mkousal/bcthesis/text/sablona-obhaj.pdf

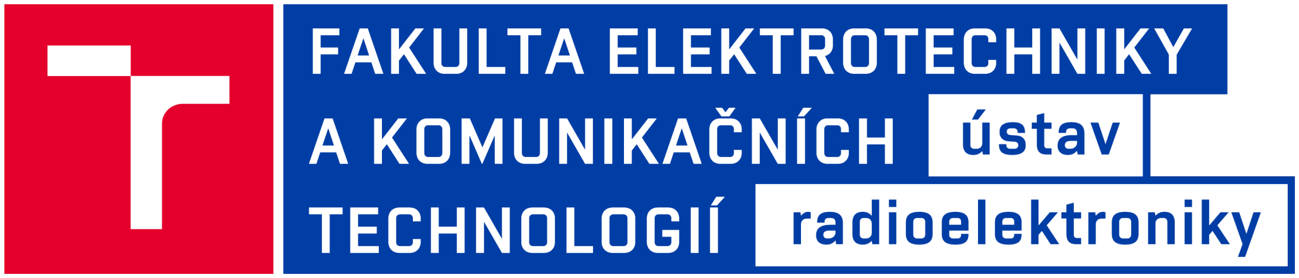
[picture p11: figure]

## IoT monitoring ovzduší

Semestrální práce

Autor práce: MARTIN KOUSAL
Vedoucí práce: doc. Ing. TOMÁŠ FRÝZA, Ph.D.
| Brno, 7. 1. 2022

## Cíle práce

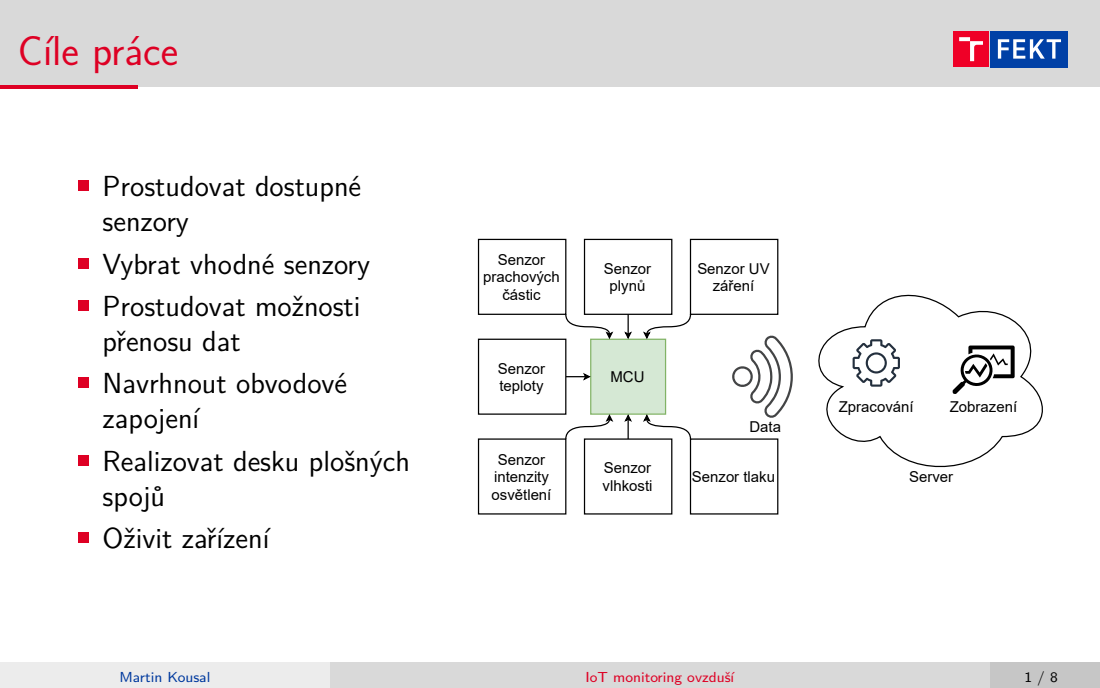
[picture p12: page 2]
MCU; Senzor prachových částic; Senzor plynů; Senzor UV záření; Senzor teploty; Senzor vlhkosti; Senzor intenzity osvětlení; Senzor tlaku; Data; Zpracování; Zobrazení; Server; Martin Kousal; IoT monitoring ovzduší

Prostudovat dostupné
senzory
Vybrat vhodné senzory
Prostudovat možnosti
přenosu dat
Navrhnout obvodové
zapojení
Realizovat desku plošných
spojů
Oživit zařízení

## Výběr senzorů - kritéria a kategorie

Kritéria
Spotřeba
Cena
Dostupnost
Komunikační sběrnice

Kategorie senzorů
Prachové částice
Oxid uhelnatý
UV záření
Intenzita osvětlení
Teplota
Tlak
Vlhkost

## Přenos a zpracování dat

Přenosové sítě
Sigfox
WiFi
LoRaWAN
NB-IoT

Server pro zpracování dat
ThingSpeak
ubidots
Arduino Cloud
Vlastní řešení
MQTT Broker
InfluxDB
Grafana

## Návrh elektroniky

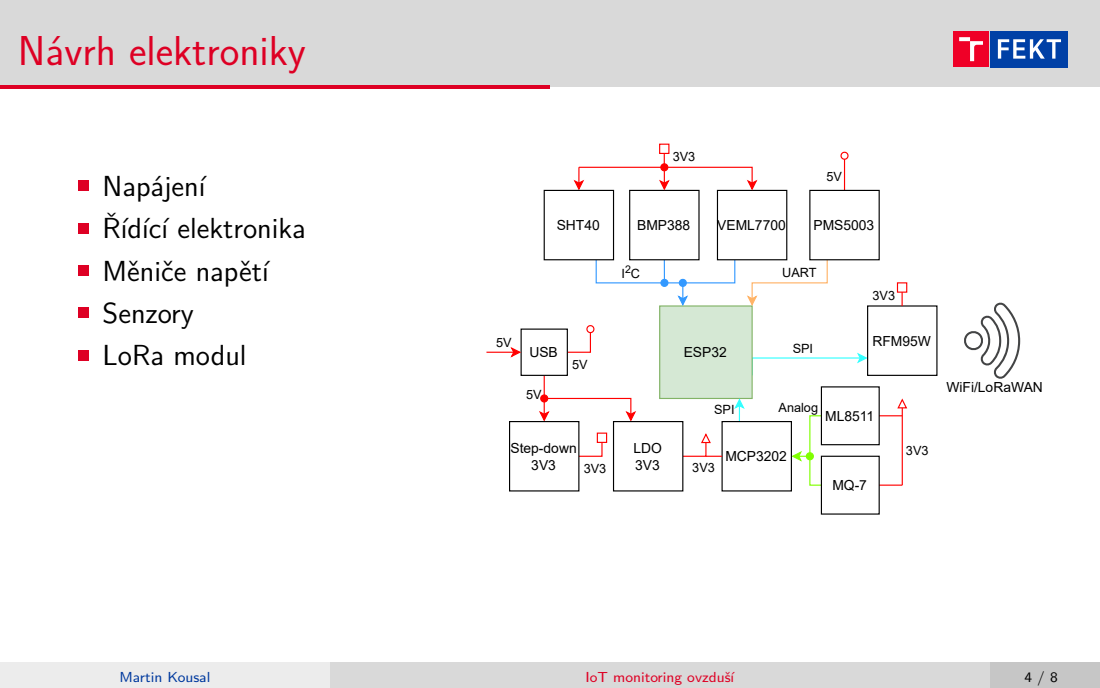
[picture p13: page 5]
Napájení Řídící elektronika; Měniče napětí; Senzory; LoRa modul; SPI ESP32; USB; WiFi/LoRaWAN; Step-down 3V3; I²C; SHT40; BMP388; VEML7700; UART; PMS5003; LDO 3V3; Analog ML8511; SPI; MCP3202; RFM95W

## Návrh DPS

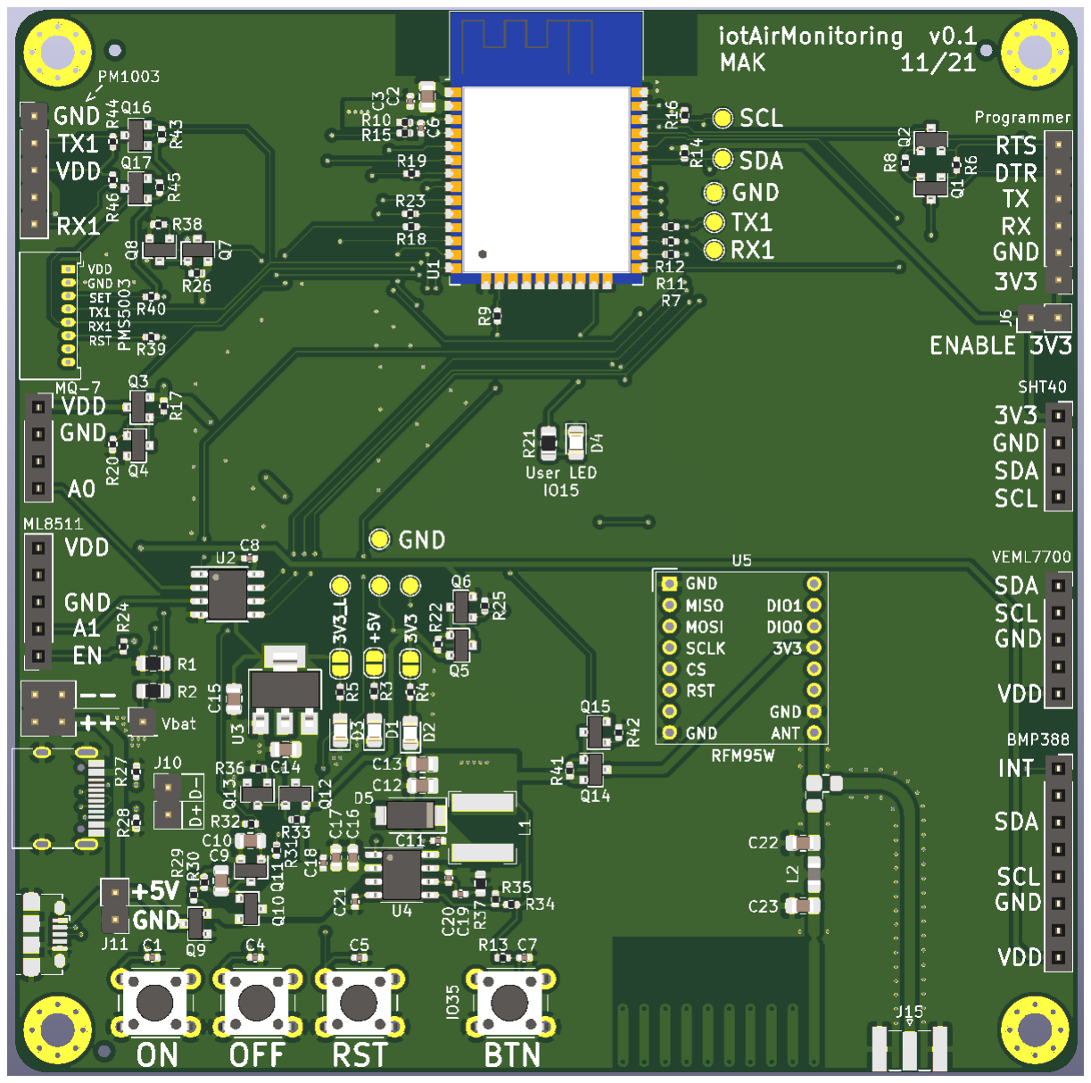
[picture p14: figure]

Dvouvrstvá DPS
Navrhováno v KiCad
Výroba JLCPCB
Strojní osazení
Velikost 100 × 100mm

## Realizovaná DPS

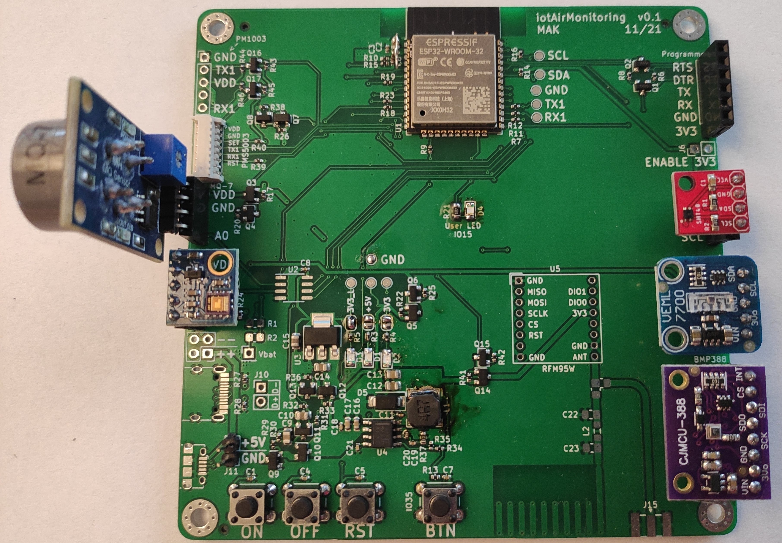
[picture p15: figure]

Osazení součástek
Možnost vypnutí
jednotlivých součástí
Spotřeba 500μA při
nečinnosti a uspaném
mikrokontroleru
Přizpůsobení antény pro
LoRa
Funkčnost všech senzorů

## Závěr

Splněné cíle
Funkční prototyp
Možnost naprogramovat mikrokontroler
Správná funkčnost dílčích logických celků
Další postup
Naprogramování firmware za použití ESP-IDF (C/C++) Vyřešení antény pro LoRa
Zprovoznění sběru dat
Další snížení klidové spotřeby Provoz na baterie

# Děkuji za pozornost!
