mkousal/bcthesis/text/nastaveni.tex

% V tomto souboru se nastavují téměř veškeré informace, proměnné mezi studenty:
% jméno, název práce, pohlaví atd.
% Tento soubor je SDÍLENÝ mezi textem práce a prezentací k obhajobě -- netřeba něco nastavovat na dvou místech.

\usepackage[
%%% Z následujících voleb jazyka lze použít pouze jednu
  czech-english,		% originální jazyk je čeština, překlad je anglicky (výchozí)
  %english-czech,	% originální jazyk je angličtina, překlad je česky
  %slovak-english,	% originální jazyk je slovenština, překlad je anglicky
  %english-slovak,	% originální jazyk je angličtina, překlad je slovensky
%
%%% Z následujících voleb typu práce lze použít pouze jednu
  %semestral,		  % semestrální práce (nesází se abstrakty, prohlášení, poděkování) (výchozí)
  bachelor,			%	bakalářská práce
  %master,			  % diplomová práce
  %treatise,			% pojednání o disertační práci
  %doctoral,			% disertační práce
%
%%% Z následujících voleb zarovnání objektů lze použít pouze jednu
%  left,				  % rovnice a popisky plovoucích objektů budou zarovnány vlevo
	center,			    % rovnice a popisky plovoucích objektů budou zarovnány na střed (vychozi)
%
]{thesis}   % Balíček pro sazbu studentských prací

%%% Jméno a příjmení autora ve tvaru
%  [tituly před jménem]{Křestní}{Příjmení}[tituly za jménem]
% Pokud osoba nemá titul před/za jménem, smažte celý řetězec '[...]'
\author{Martin}{Kousal}

%%% Identifikační číslo autora (VUT ID)
\butid{221063}

%%% Pohlaví autora/autorky
% (nepoužije se ve variantě english-czech ani english-slovak)
% Číselná hodnota: 1...žena, 0...muž
\gender{0}

%%% Jméno a příjmení vedoucího/školitele včetně titulů
%  [tituly před jménem]{Křestní}{Příjmení}[tituly za jménem]
% Pokud osoba nemá titul před/za jménem, smažte celý řetězec '[...]'
\advisor[doc. Ing.]{Tomáš}{Frýza}[Ph.D.]

%%% Jméno a příjmení oponenta včetně titulů
%  [tituly před jménem]{Křestní}{Příjmení}[tituly za jménem]
% Pokud osoba nemá titul před/za jménem, smažte celý řetězec '[...]'
% Nastavení oponenta se uplatní pouze v prezentaci k obhajobě;
% v případě, že nechcete, aby se na titulním snímku prezentace zobrazoval oponent, pouze příkaz zakomentujte;
% u obhajoby semestrální práce se oponent nezobrazuje (jelikož neexistuje)
% U dizertační práce jsou typicky dva až tři oponenti. Pokud je chcete mít na titulním slajdu, prosím ručně odkomentujte a upravte jejich jména v definici "VUT title page" v souboru thesis.sty.
\opponent[Ing.]{Aleš}{Povalač}[Ph.D.]

%%% Název práce
%  Parametr ve složených závorkách {} je název v originálním jazyce,
%  parametr v hranatých závorkách [] je překlad (podle toho jaký je originální jazyk).
%  V případě, že název Vaší práce je dlouhý a nevleze se celý do zápatí prezentace, použijte příkaz
%  \def\insertshorttitle{Zkác.\ náz.\ práce}
%  kde jako parametr vyplníte zkrácený název. Pokud nechcete zkracovat název, budete muset předefinovat,
%  jak se vytváří patička slidu. Viz odkaz: https://bit.ly/3EJTp5A
\title[IoT air monitoring]{IoT monitoring ovzduší}

%%% Označení oboru studia
%  Parametr ve složených závorkách {} je název oboru v originálním jazyce,
%  parametr v hranatých závorkách [] je překlad
\specialization[Electronics and Communication Technologies]{Elektronika a komunikační technologie}

%%% Označení ústavu
%  Parametr ve složených závorkách {} je název ústavu v originálním jazyce,
%  parametr v hranatých závorkách [] je překlad
%\department[Department of Control and Instrumentation]{Ústav automatizace a měřicí techniky}
%\department[Department of Biomedical Engineering]{Ústav biomedicínského inženýrství}
%\department[Department of Electrical Power Engineering]{Ústav elektroenergetiky}
%\department[Department of Electrical and Electronic Technology]{Ústav elektrotechnologie}
%\department[Department of Physics]{Ústav fyziky}
%\department[Department of Foreign Languages]{Ústav jazyků}
%\department[Department of Mathematics]{Ústav matematiky}
%\department[Department of Microelectronics]{Ústav mikroelektroniky}
\department[Department of Radio Electronics]{Ústav radioelektroniky}
%\department[Department of Theoretical and Experimental Electrical Engineering]{Ústav teoretické a experimentální elektrotechniky}
%\department[Department of Telecommunications]{Ústav telekomunikací}
%\department[Department of Power Electrical and Electronic Engineering]{Ústav výkonové elektrotechniky a elektroniky}

%%% Označení fakulty
%  Parametr ve složených závorkách {} je název fakulty v originálním jazyce,
%  parametr v hranatých závorkách [] je překlad
%\faculty[Faculty of Architecture]{Fakulta architektury}
\faculty[Faculty of Electrical Engineering and~Communication]{Fakulta elektrotechniky a~komunikačních technologií}
%\faculty[Faculty of Chemistry]{Fakulta chemická}
%\faculty[Faculty of Information Technology]{Fakulta informačních technologií}
%\faculty[Faculty of Business and Management]{Fakulta podnikatelská}
%\faculty[Faculty of Civil Engineering]{Fakulta stavební}
%\faculty[Faculty of Mechanical Engineering]{Fakulta strojního inženýrství}
%\faculty[Faculty of Fine Arts]{Fakulta výtvarných umění}
%
%Nastavení logotypu (v hranatych zavorkach zkracene logo, ve slozenych plne):
\facultylogo[logo/FEKT_zkratka_barevne_PANTONE_CZ]{logo/logo_fekt_urel_cze}

%%% Rok odevzdání práce
\graduateyear{2022}
%%% Akademický rok odevzdání práce
\academicyear{2021/22}

%%% Datum obhajoby (uplatní se pouze v prezentaci k obhajobě)
\date{14.\,6.\,2022}

%%% Místo obhajoby
% Na titulních stránkách bude automaticky vysázeno VELKÝMI písmeny (pokud tyto stránky sází šablona)
\city{Brno}

%%% Abstrakt
\abstract[%
The purpose of this bachelor work is to make a device that can measure air quality parameters and send them wirelessly to the server, where that measured data are processed and then shown to the user. The aim is to create a device with the lowest possible power consumption for the possibility of battery operation.
]{%
Tato bakalářská práce se zabývá vytvořením zařízení pro měření kvalitativních parametrů ovzduší a které je následně bezdrátově přenáší na server, kde se naměřená data zpracovávají a zobrazují uživateli. Cílem je vytvořit zařízení s co nejnižším odběrem pro možnost provozu na akumulátor.
}

%%% Klíčová slova
\keywrds[%
IoT, ESP32, sensors, dust particles sensor, air quality, LoRa, gas sensor, temperature, humidity, light intensity, UV light
]{%
IoT, ESP32, senzory, senzor prachových částic, kvalita vzduchu, LoRa, senzor plynů, teplota, vlhkost, intenzita osvětlení, UV záření
}

%%% Poděkování
\acknowledgement{%
Rád bych poděkoval vedoucímu bakalářské práce
panu doc.~Ing.~Tomáši Frýzovi, Ph.D.\ za odborné vedení,
konzultace, trpělivost a~podnětné návrhy k~práci.
}%
