mkousal/bcthesis/text/obrazky/flowchart.pdf

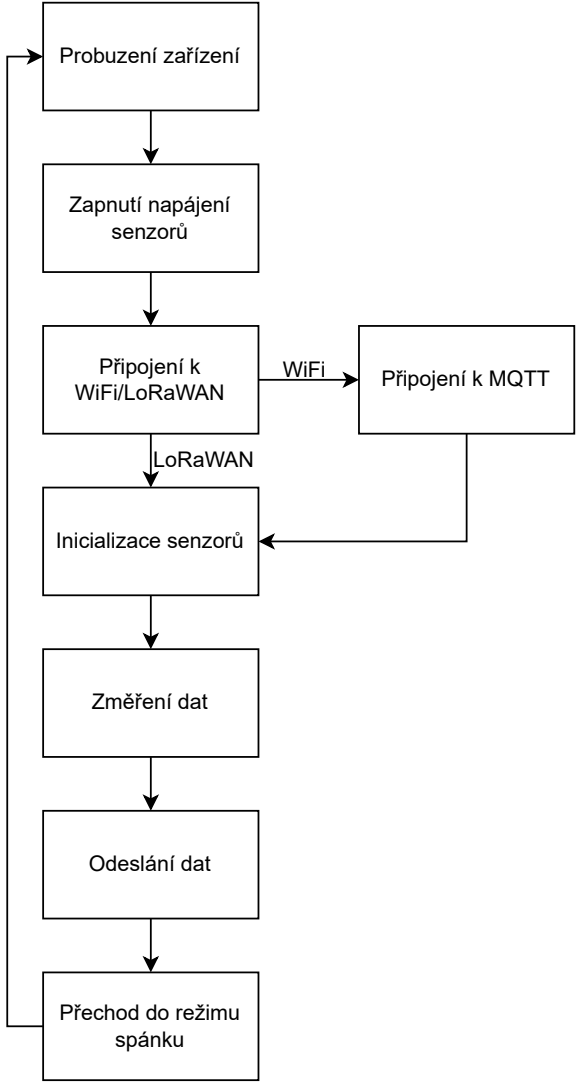
[picture p36: figure]
Probuzení zařízení; Zapnutí napájení senzorů; Připojení k WiFi/LoRaWAN; Inicializace senzorů; Změření dat; Připojení k MQTT; Odeslání dat; Přechod do režimu spánku; WiFi; LoRaWAN
