mkousal/bcthesis/text/obrazky/mq7.jpg

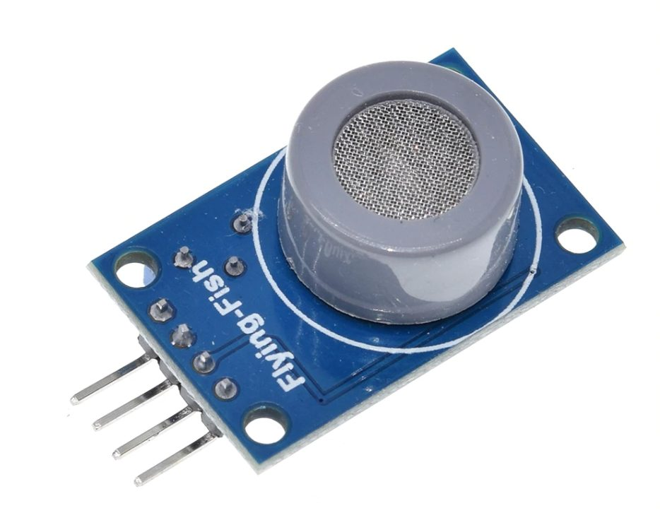
text/obrazky/mq7.jpg
