mkousal/bcthesis/text/obrazky/PCB_top.png

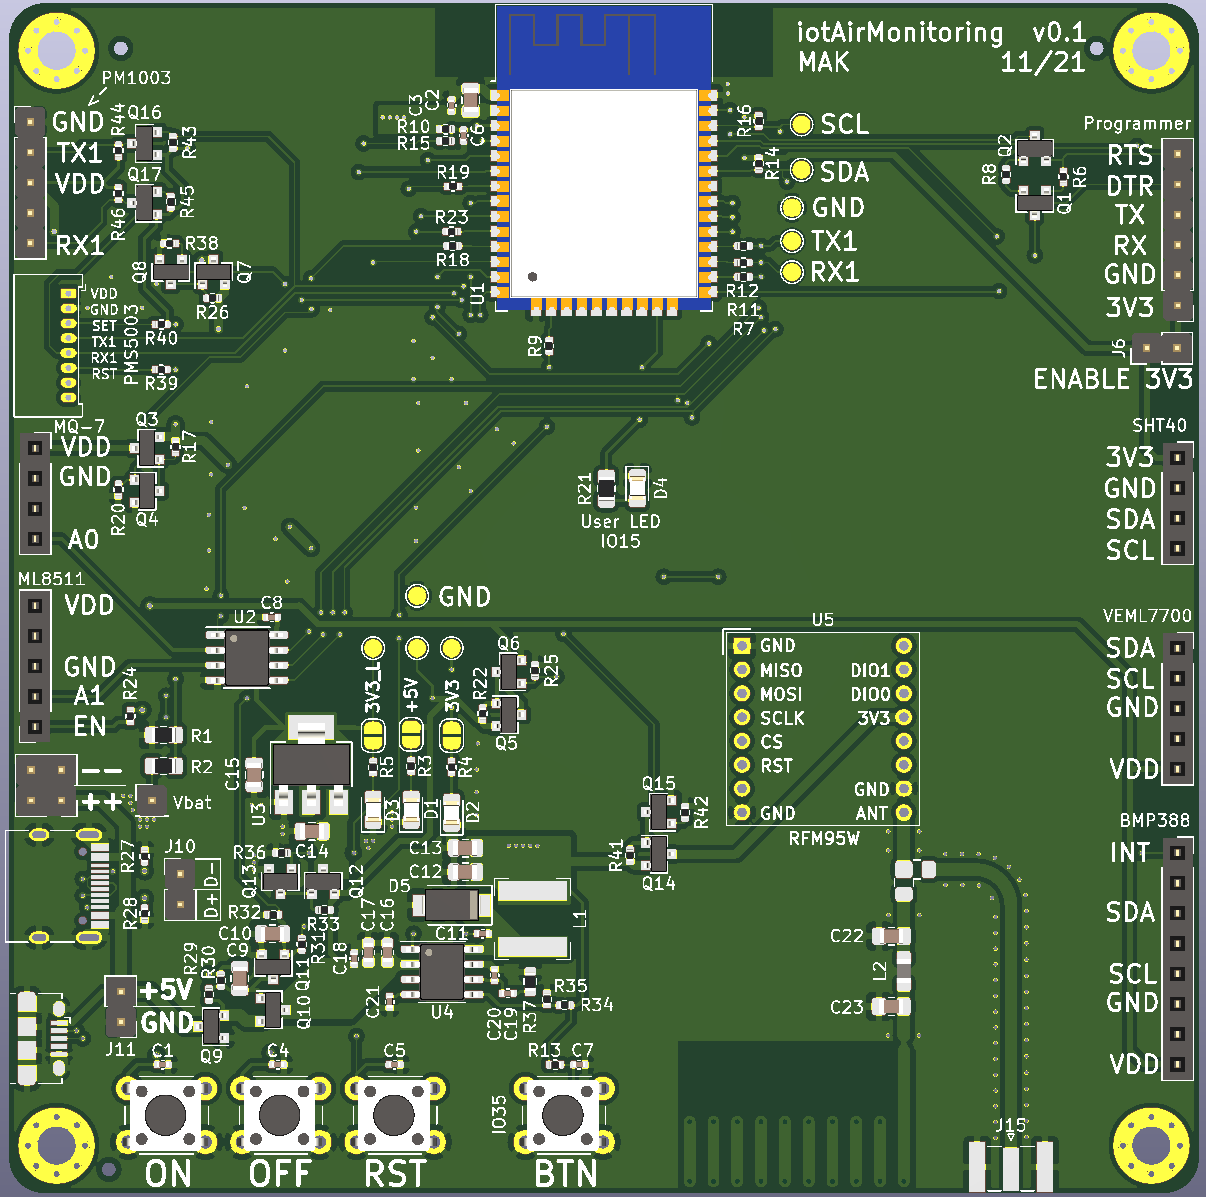
text/obrazky/PCB_top.png
