mkousal/bcthesis/text/obrazky/schematicTPS54331.png

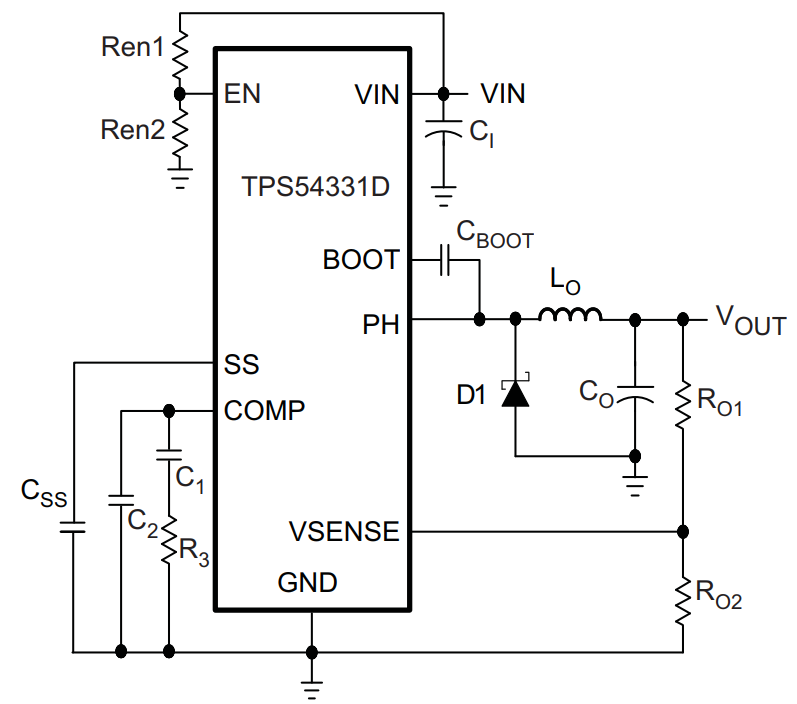
text/obrazky/schematicTPS54331.png
