mkousal/bcthesis/mec/case_bot.SLDPRT

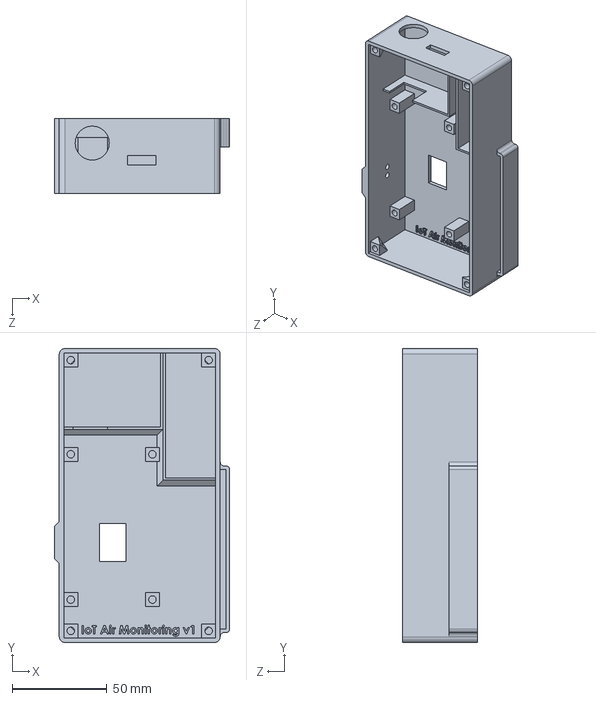
[picture p43: CAD file, 2022-05-26]
mec/case_bot.SLDPRT
92.4 x 154.8 x 39.4 mm
