mkousal/bcthesis/mec/case_top.SLDPRT

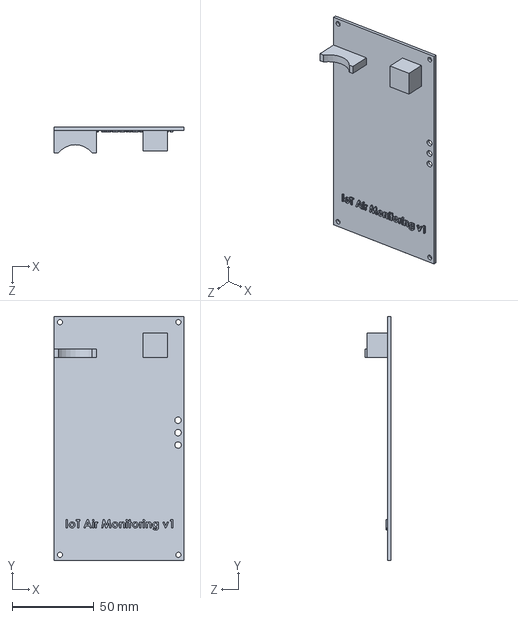
[picture p44: CAD file, 2022-05-26]
mec/case_top.SLDPRT
79.6 x 149.6 x 15.8 mm
