mkousal/bcthesis/text/obrazky/block_schematic-full.drawio.pdf

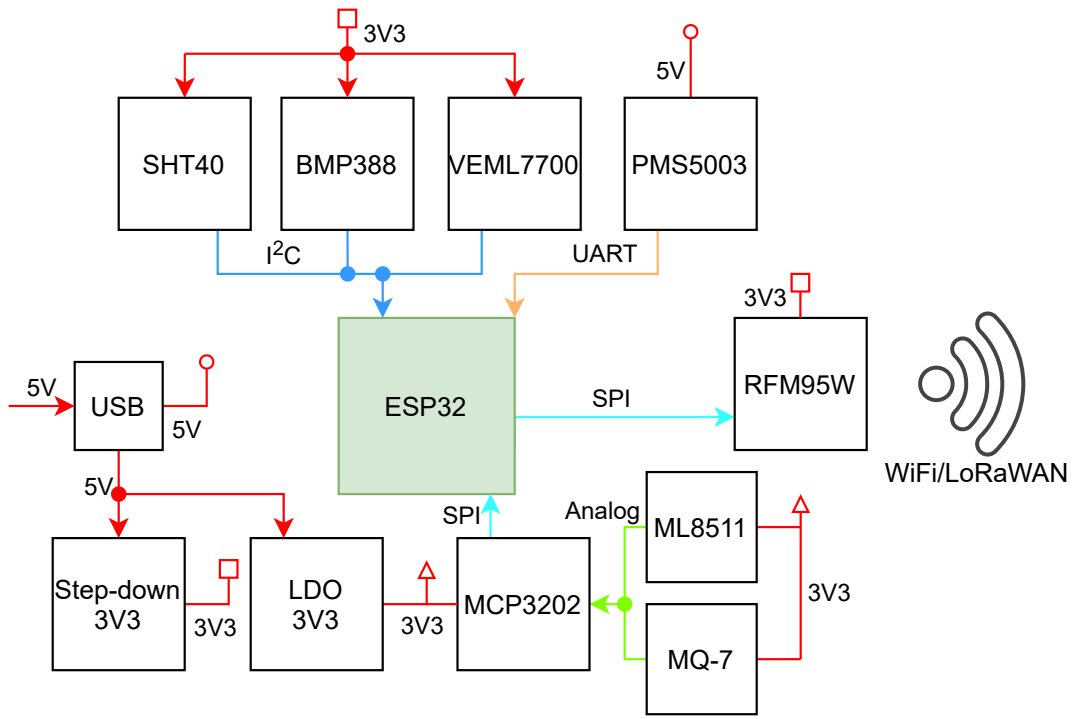
[picture p45: page 1]
SPI ESP32; USB; WiFi/LoRaWAN; Step-down 3V3; SHT40; BMP388; VEML7700; UART; PMS5003; LDO 3V3; Analog ML8511; SPI; MCP3202; RFM95W
