mkousal/bcthesis/text/obrazky/mainBoard.pdf

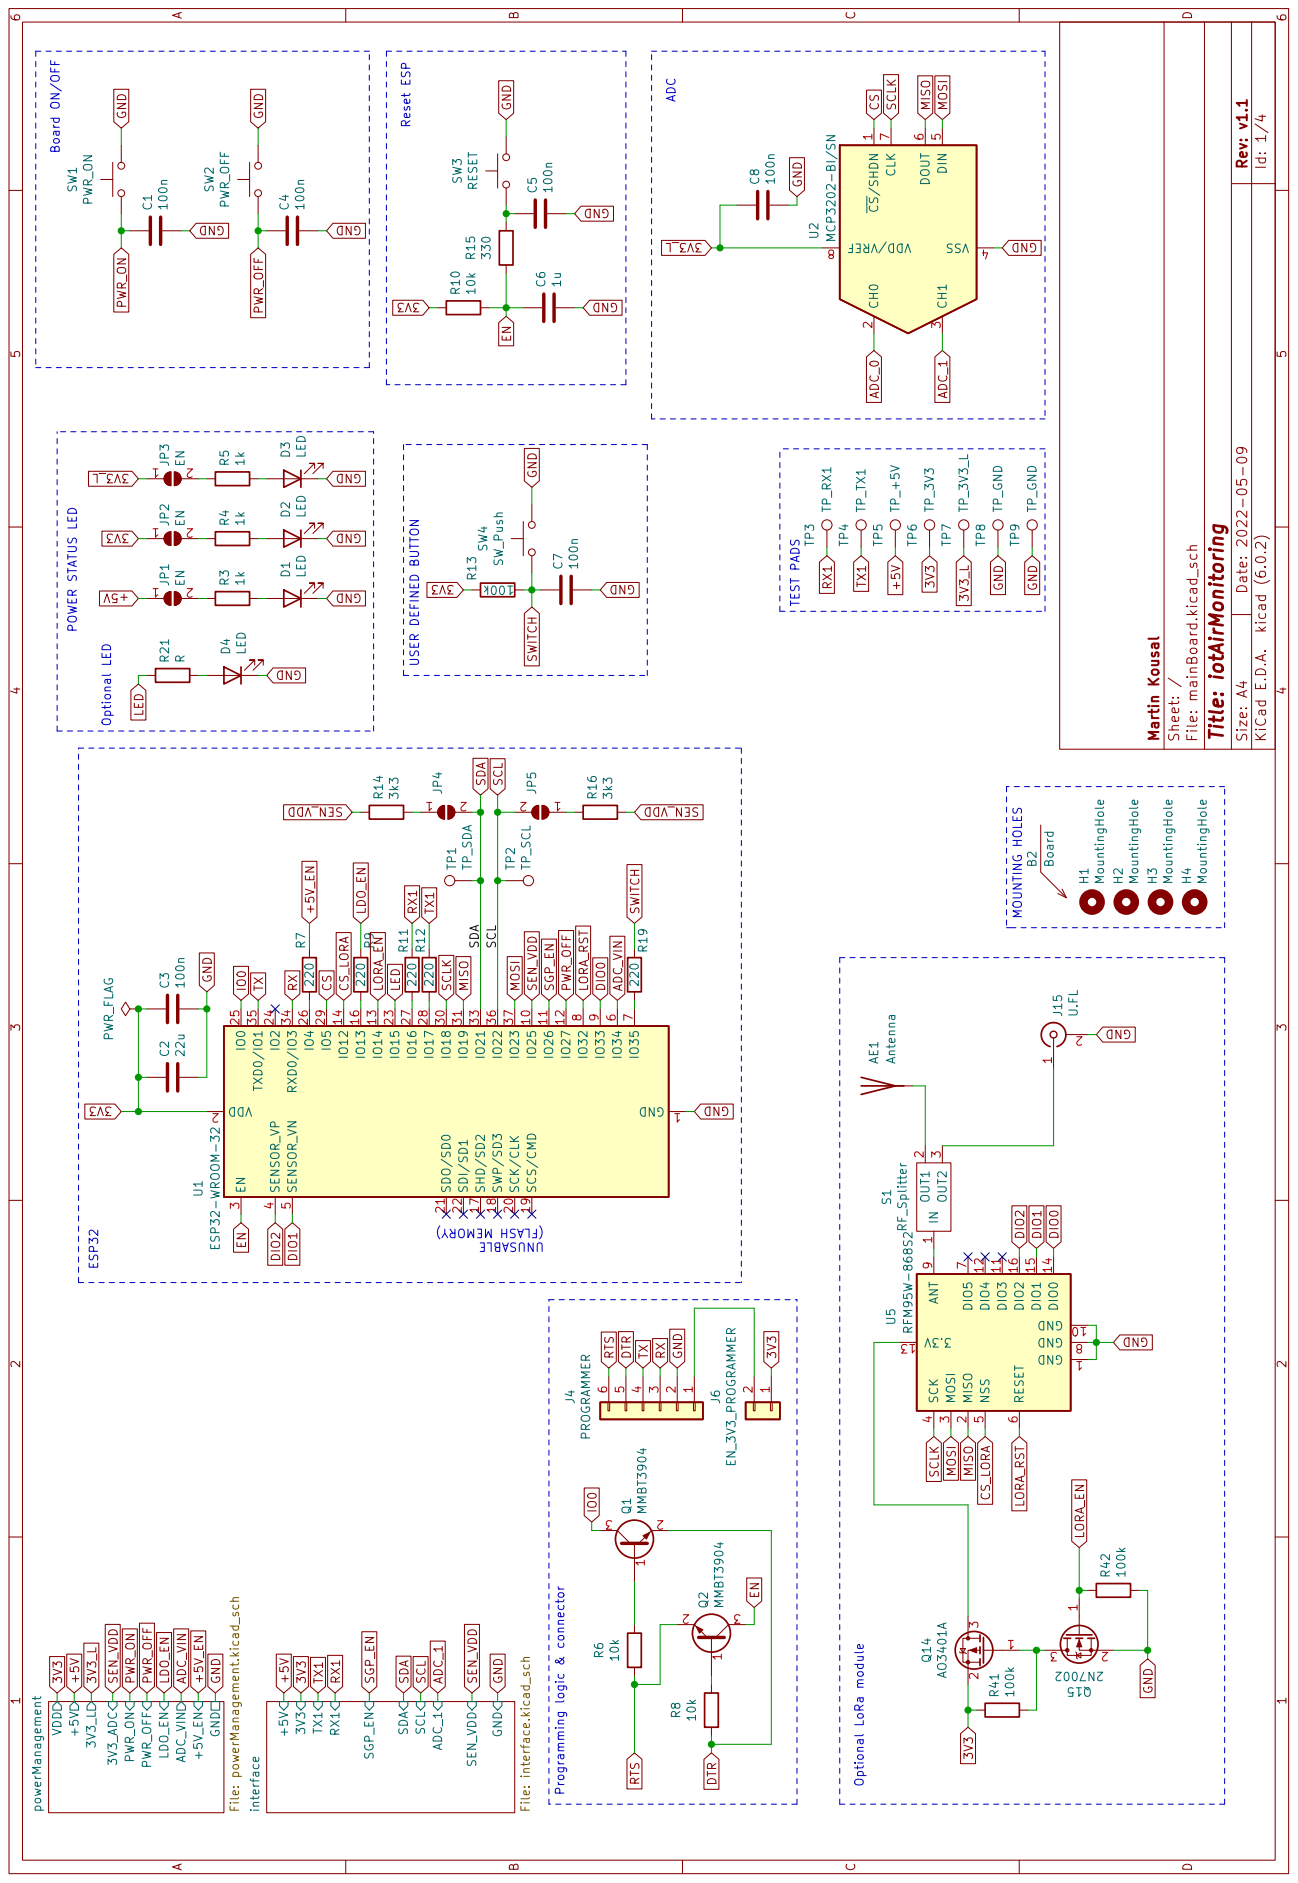
[picture p46: page 1]

D Date: 2022-05-09 KiCad E.D.A. kicad (6.0.2) Rev: v1.1 Size: A4

Board ON/OFF ADC

Programming logic & connector Reset ESP UNUSABLE (FLASH MEMORY) ESP32

SWITCH GND GND 3V3 GND GND 3V3_L ADC_0 ADC_1 GND GND MISO MOSI GND

RX RTS DTR GND 3V3

Id: 1/4 Martin Kousal Sheet: / File: mainBoard.kicad_sch

interface File: interface.kicad_sch TP6 TP_3V3 GND

TEST PADS USER DEFINED BUTTON Optional LED

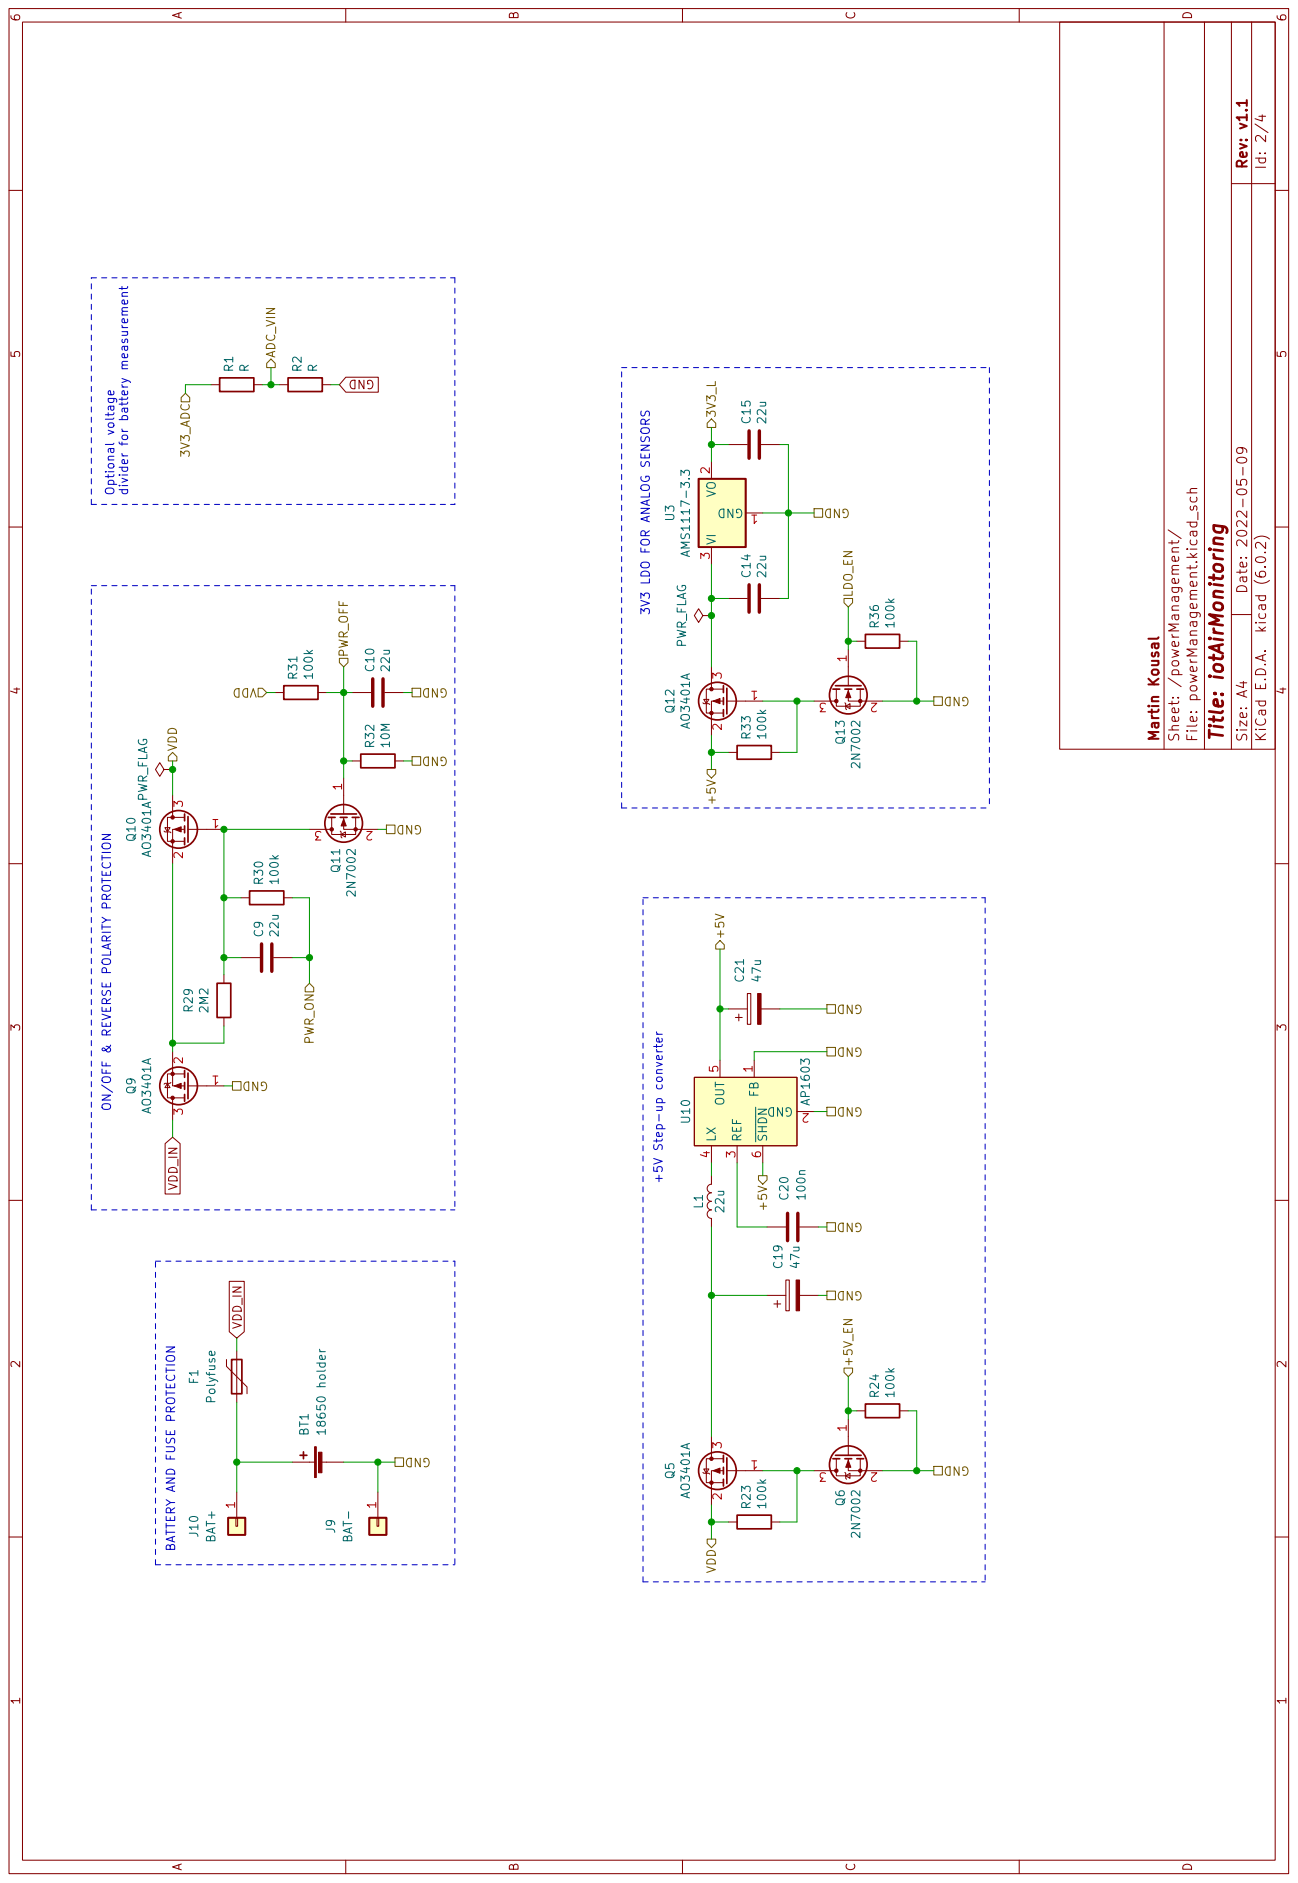
[picture p47: page 2]
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

Id: 2/4 Martin Kousal Sheet: /powerManagement/

divider for battery measurement 3V3 LDO FOR ANALOG SENSORS ON/OFF & REVERSE POLARITY PROTECTION

VDD_IN BATTERY AND FUSE PROTECTION Optional voltage

22u GND GND GND GND

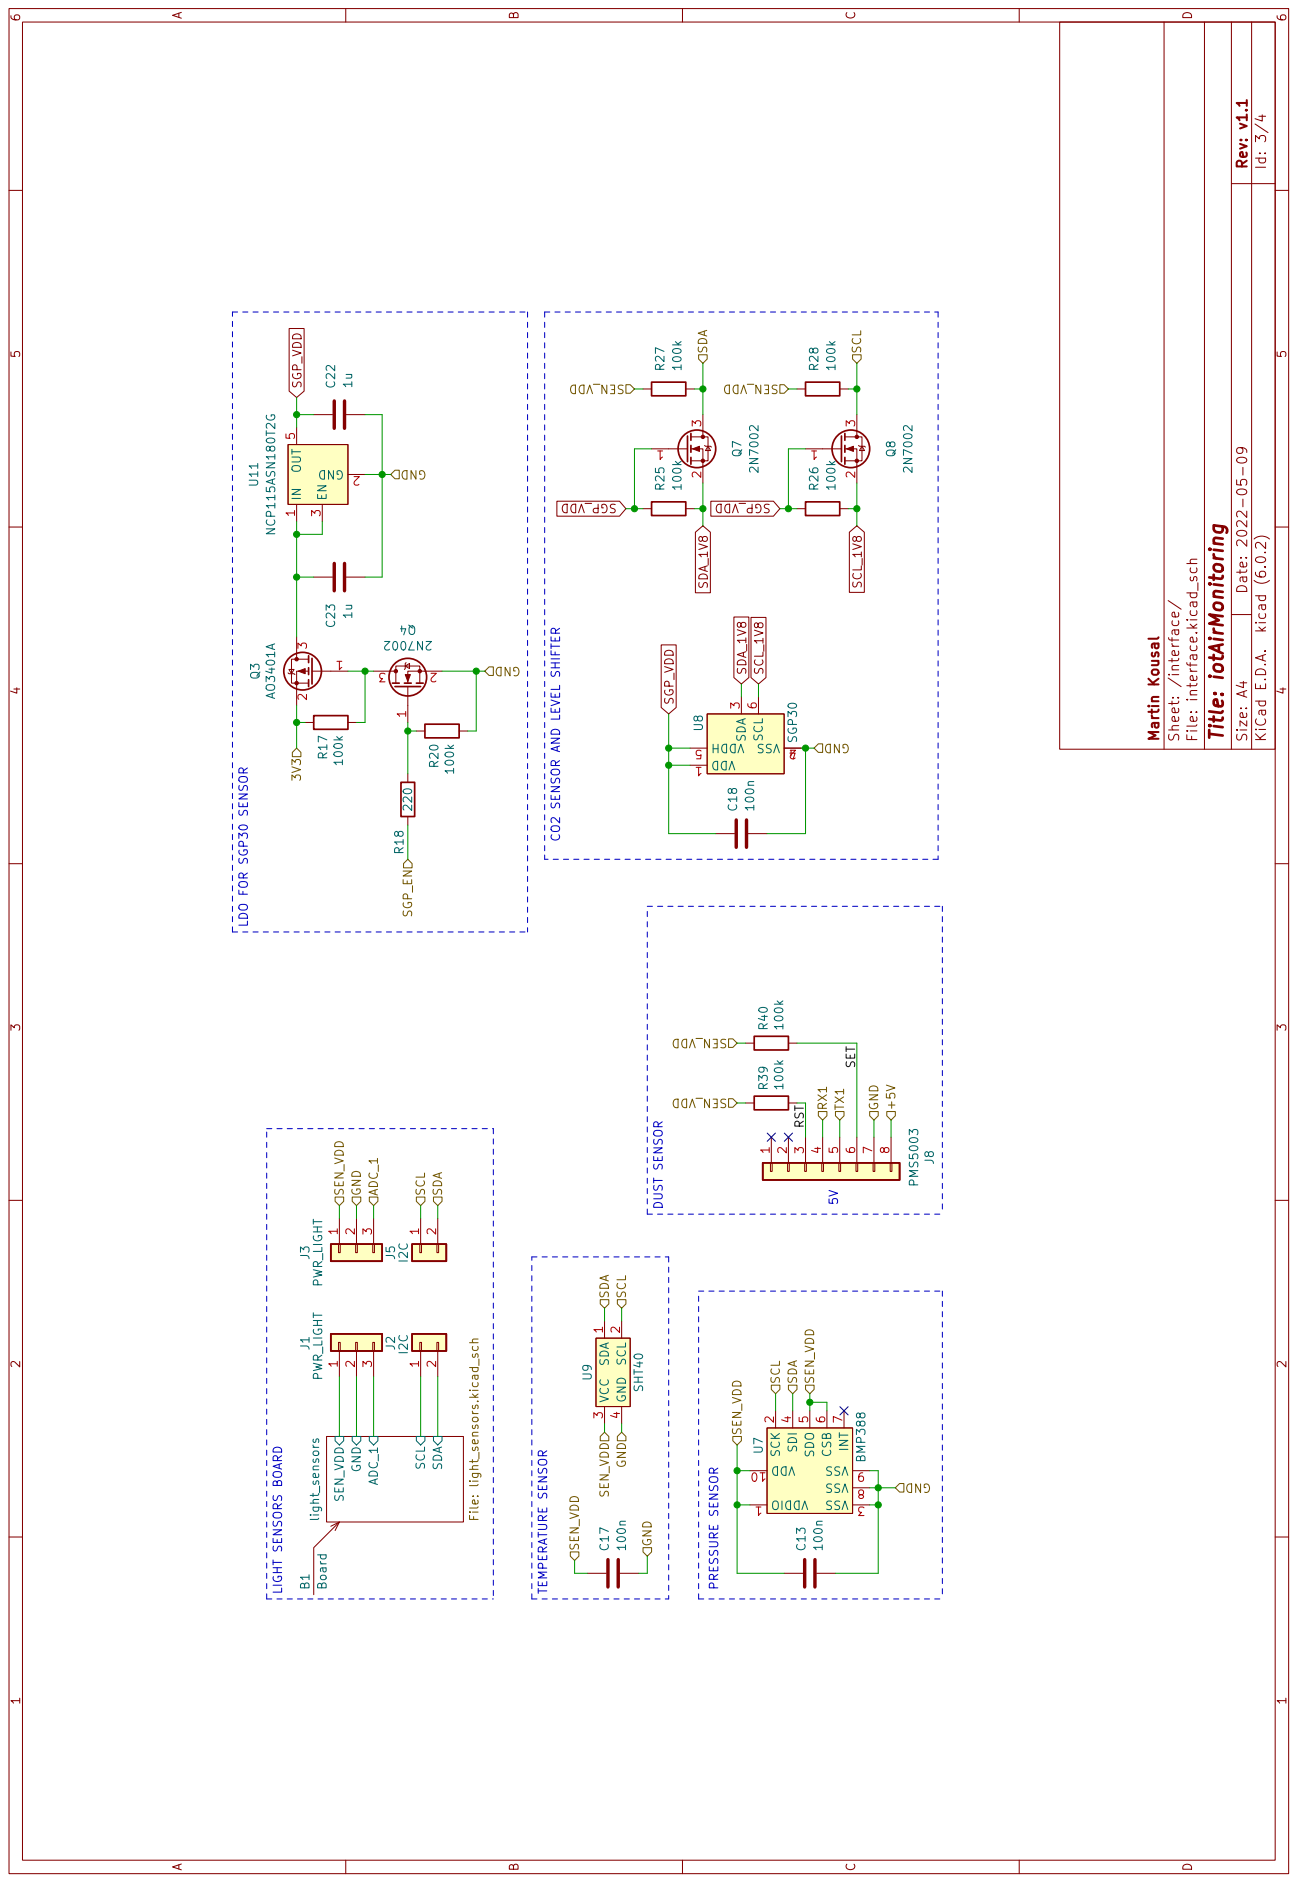
[picture p48: page 3]
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

Id: 3/4 Martin Kousal Sheet: /interface/ File: interface.kicad_sch

5V CO2 SENSOR AND LEVEL SHIFTER

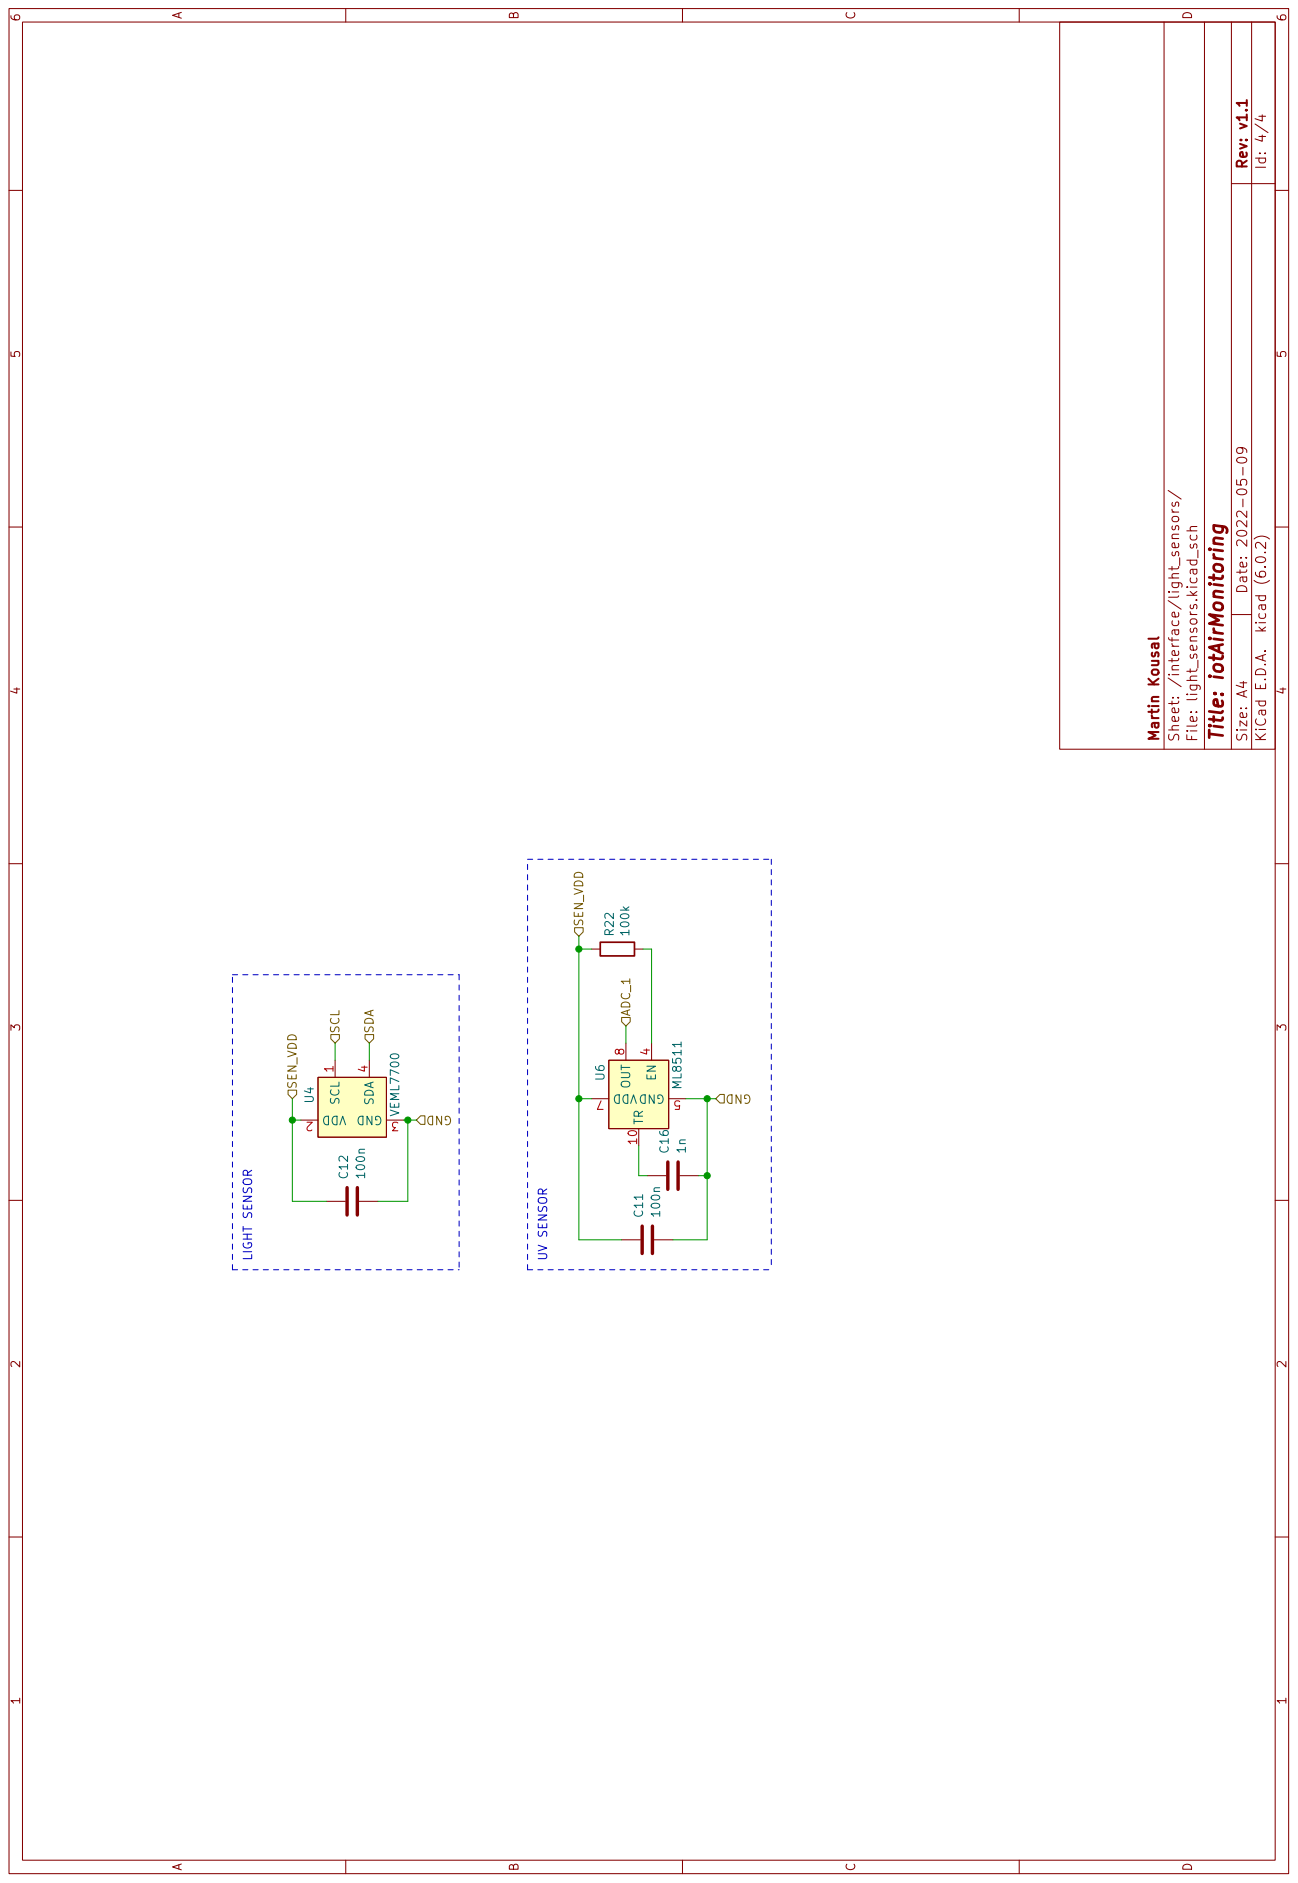
[picture p49: page 4]
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

Id: 4/4 Martin Kousal Sheet: /interface/light_sensors/
