mkousal/bcthesis/text/obrazky/batteryCharger.pdf

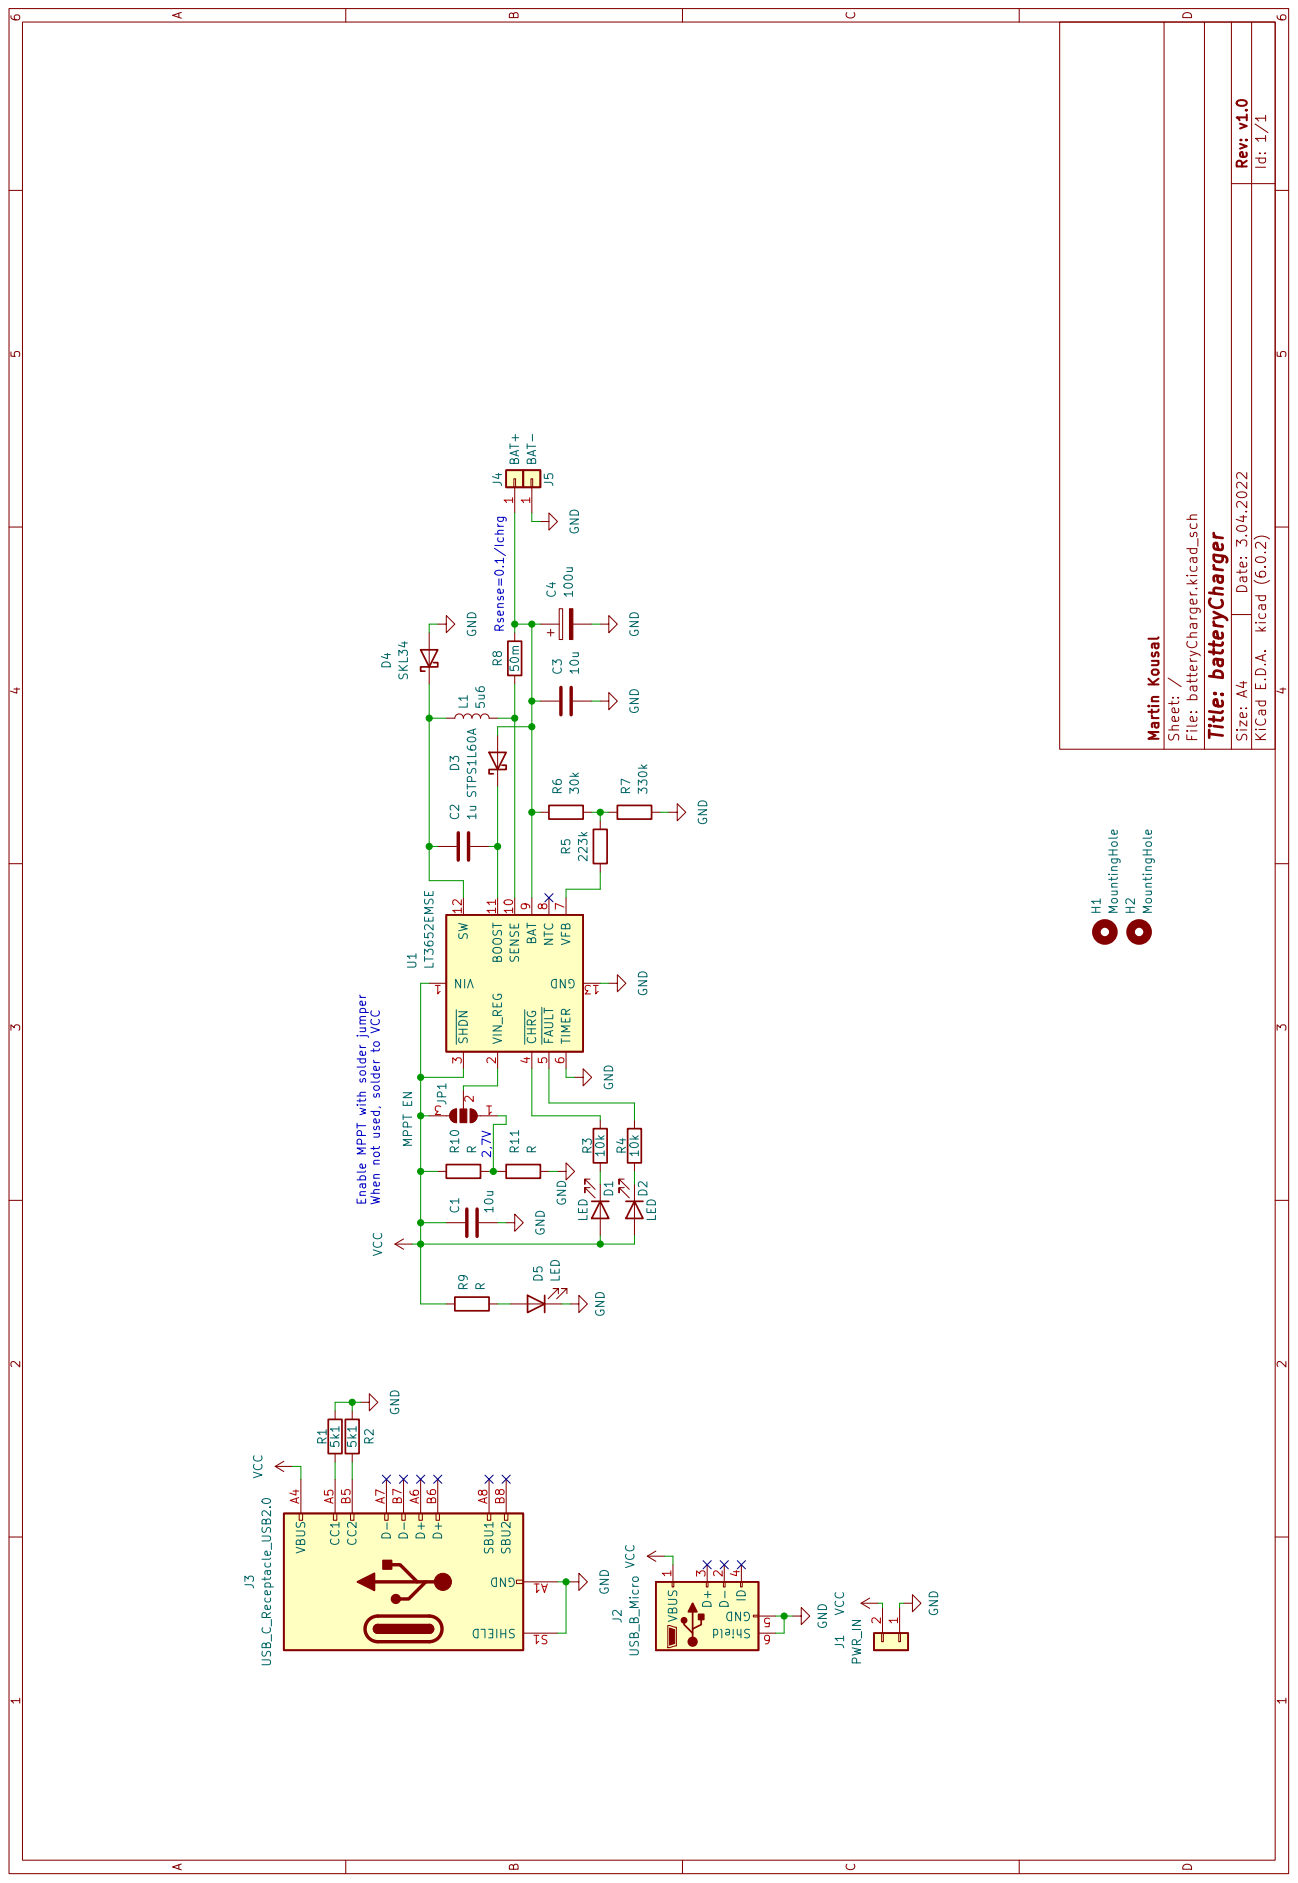
[picture p50: page 1]

D Date: 3.04.2022 KiCad E.D.A. kicad (6.0.2) Rev: v1.0 Size: A4

Id: 1/1 Martin Kousal Sheet: / File: batteryCharger.kicad_sch

2 ~{SHDN} 3 ~{CHRG} 4 ~{FAULT} 5 TIMER

2,7V Enable MPPT with solder jumper When not used, solder to VCC
