mkousal/bcthesis/text/obrazky/iotAirMonitoring.pdf

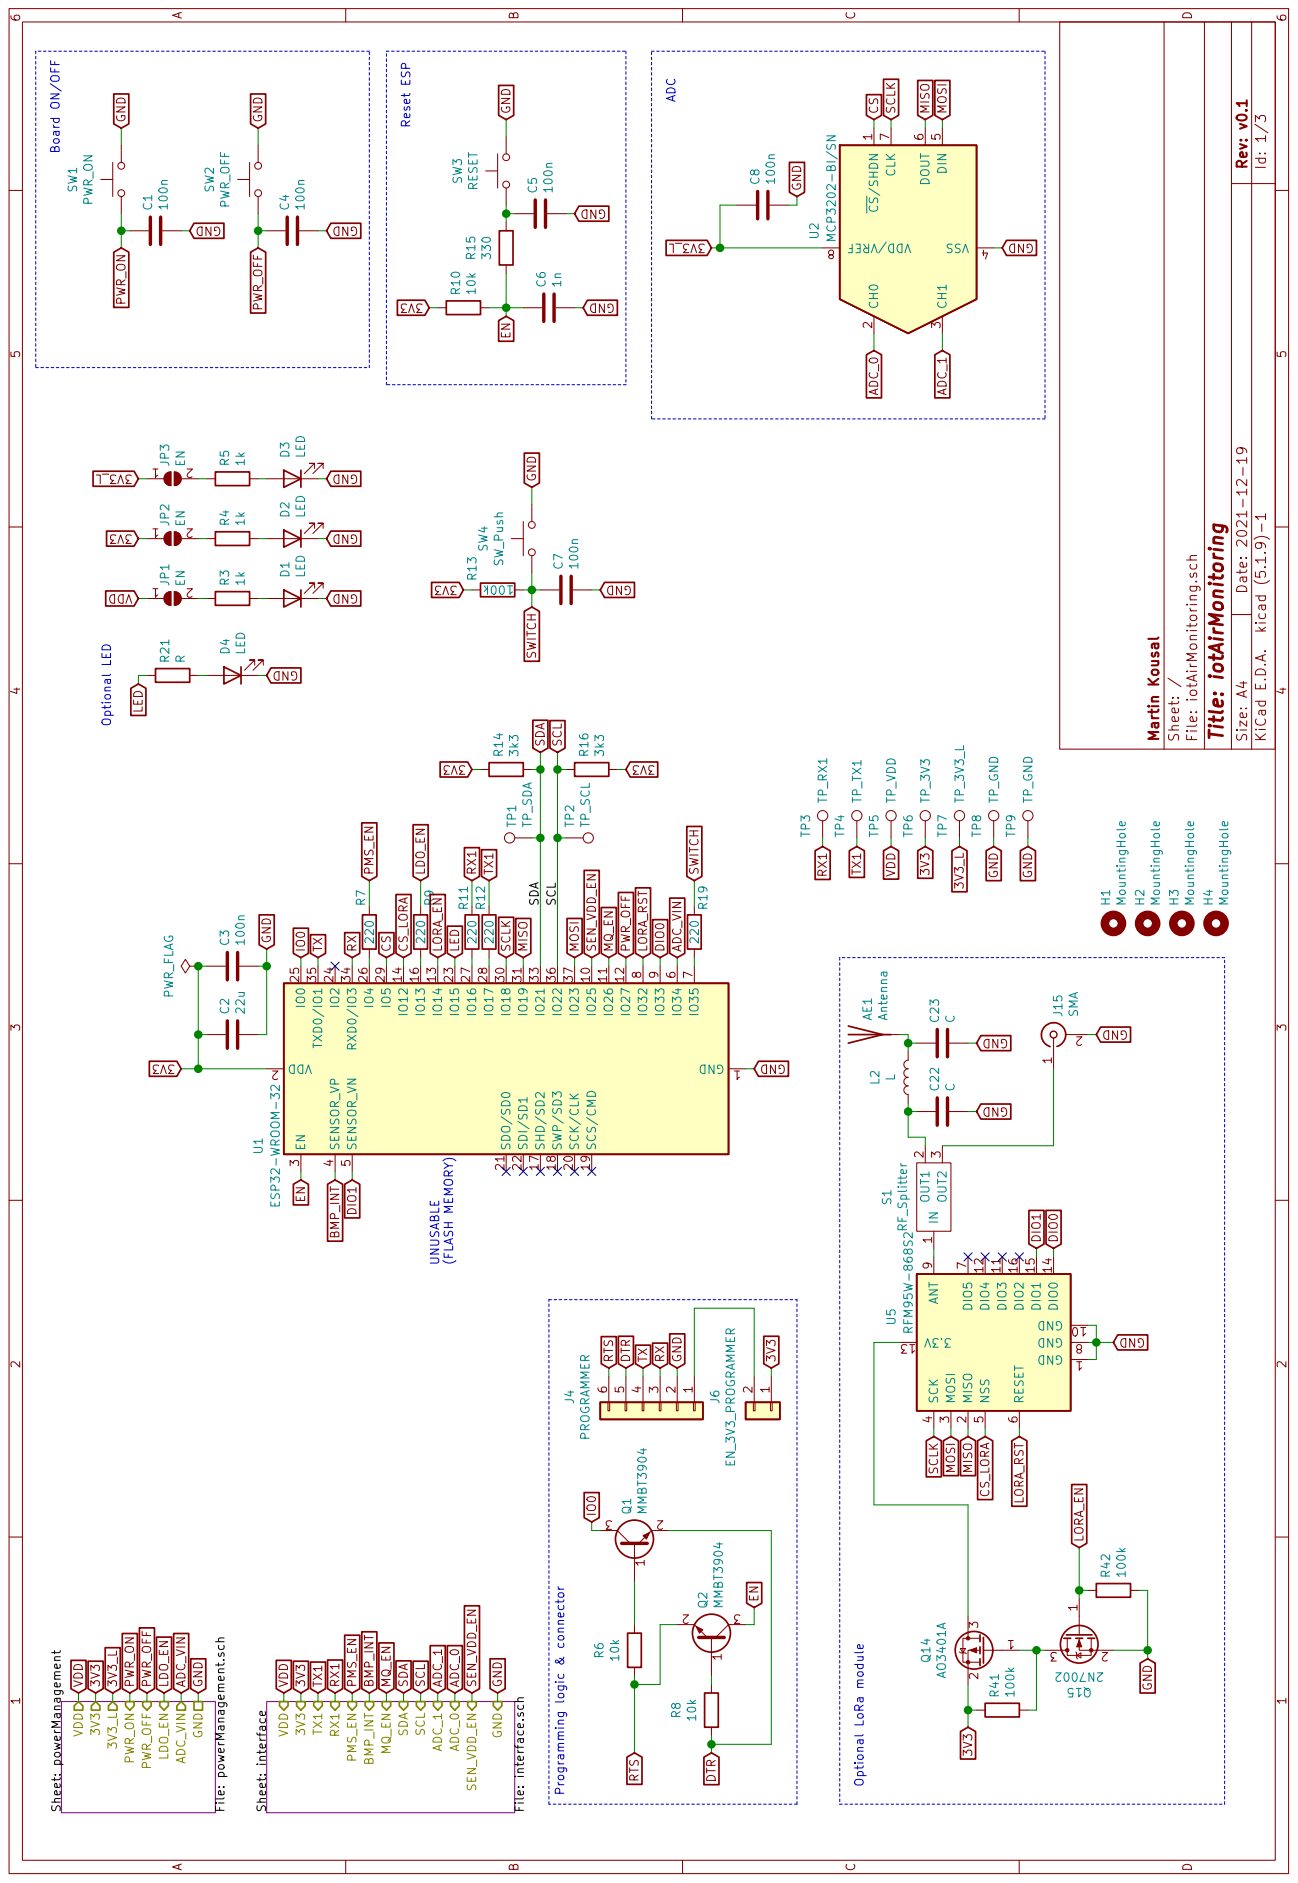
[picture p51: page 1]

D Date: 2021-12-19 KiCad E.D.A. kicad (5.1.9)-1 Rev: v0.1 Size: A4

(FLASH MEMORY) Board ON/OFF Programming logic & connector ADC

Reset ESP Optional LED

LDO_EN GND GND GND GND GND VDD 3V3 3V3_L GND GND 3V3 GND

DIO1 DIO0 DIO0 GND GND GND GND 3V3 3V3 GND GND

Id: 1/3 Martin Kousal Sheet: / File: iotAirMonitoring.sch

SCL Optional LoRa module UNUSABLE

SCLK MISO MOSI EN

File: powerManagement.sch GND

Sheet: interface File: interface.schTX1 RX1 GND

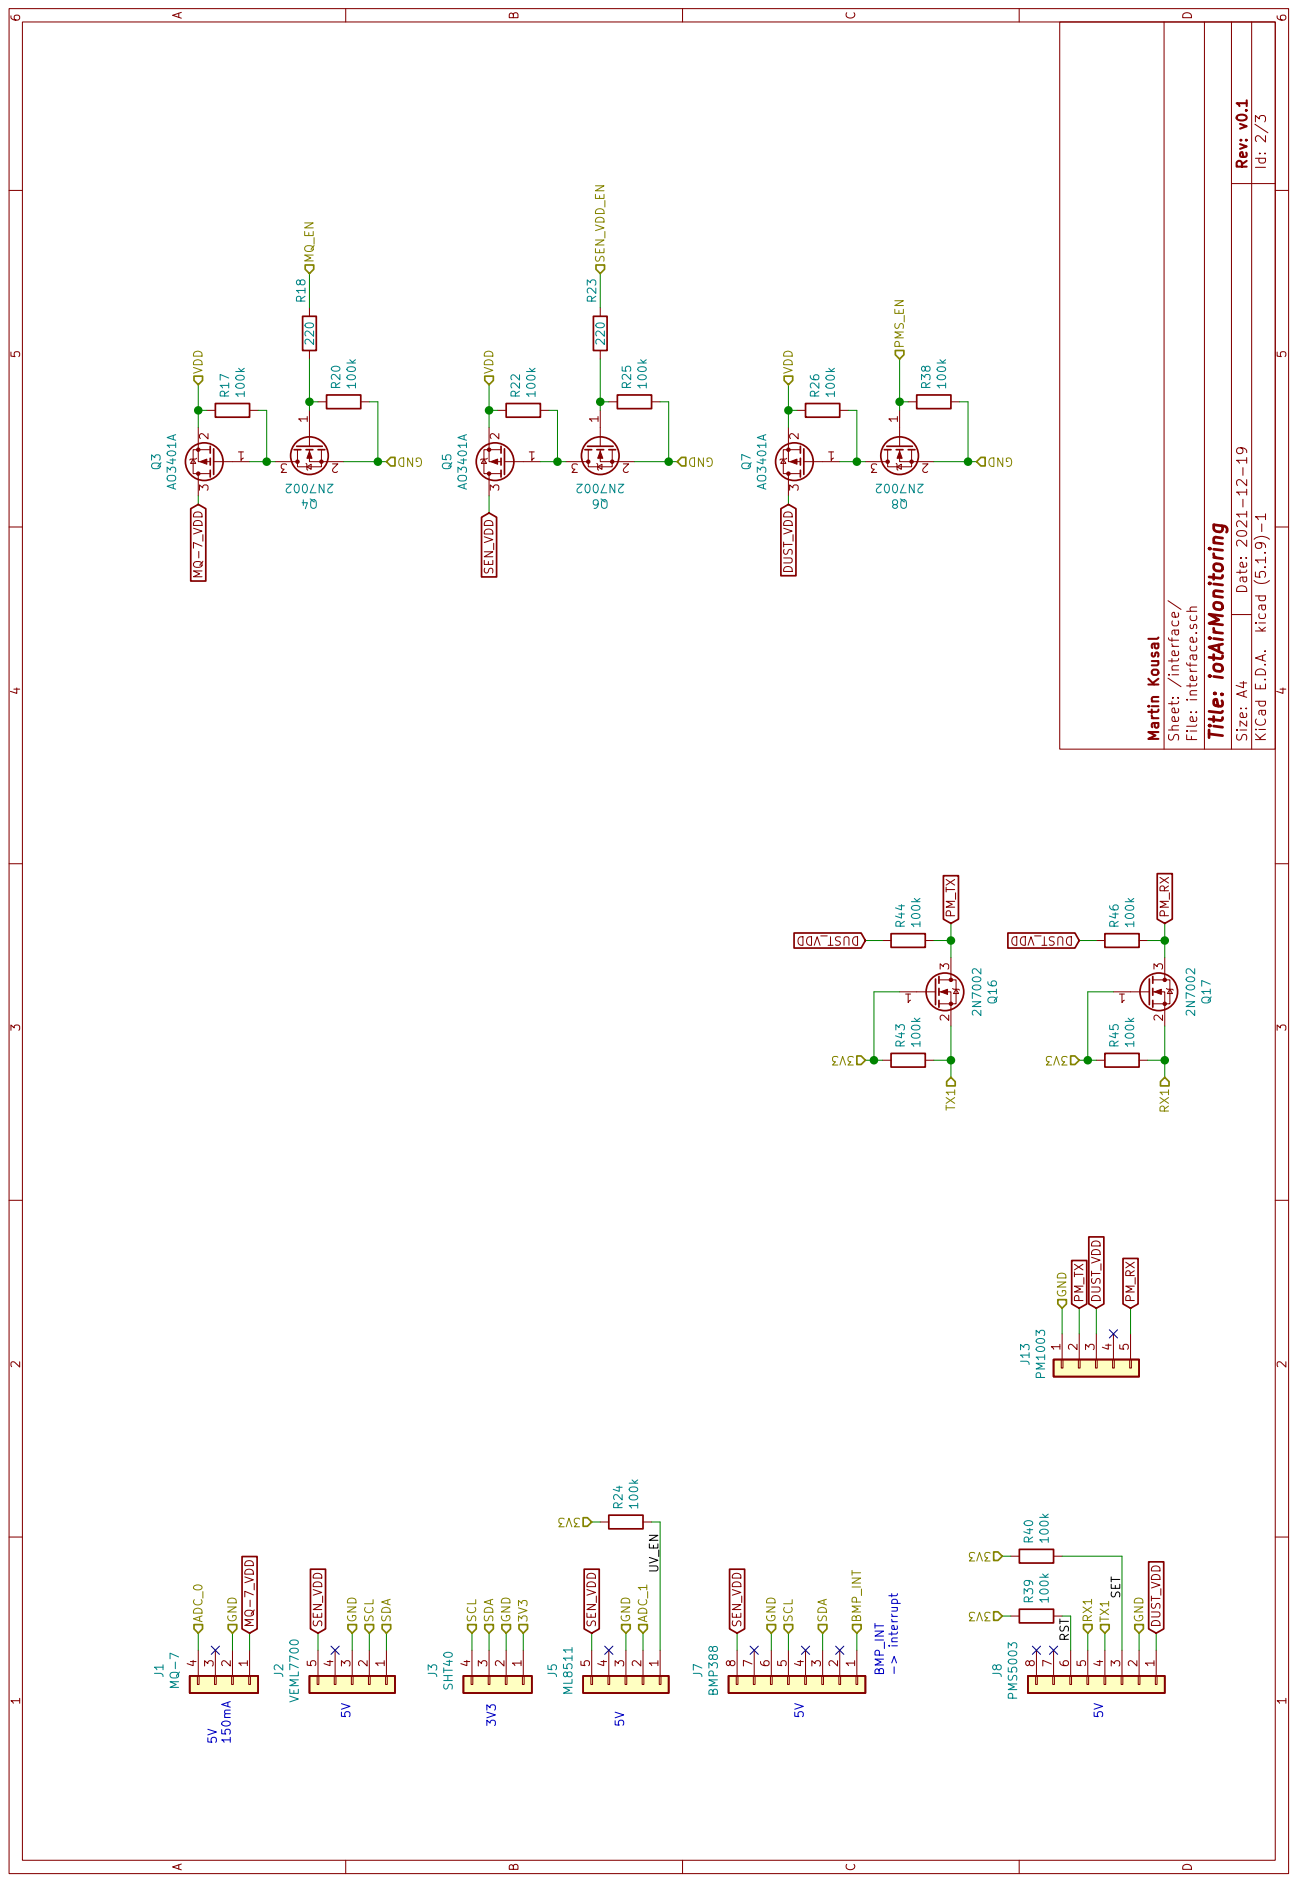
[picture p52: page 2]

1 2 3 4 5 6 1 2 3 4 5 6 ABCD ABCD Date: 2021-12-19 KiCad E.D.A. kicad (5.1.9)-1 Rev: v0.1 Size: A4

Id: 2/3 Martin Kousal Sheet: /interface/ File: interface.sch Title: iotAirMonitoring 1 2 3 Q5 AO3401A 4321

BMP_INT 3V3 SCL SCL SDA GND

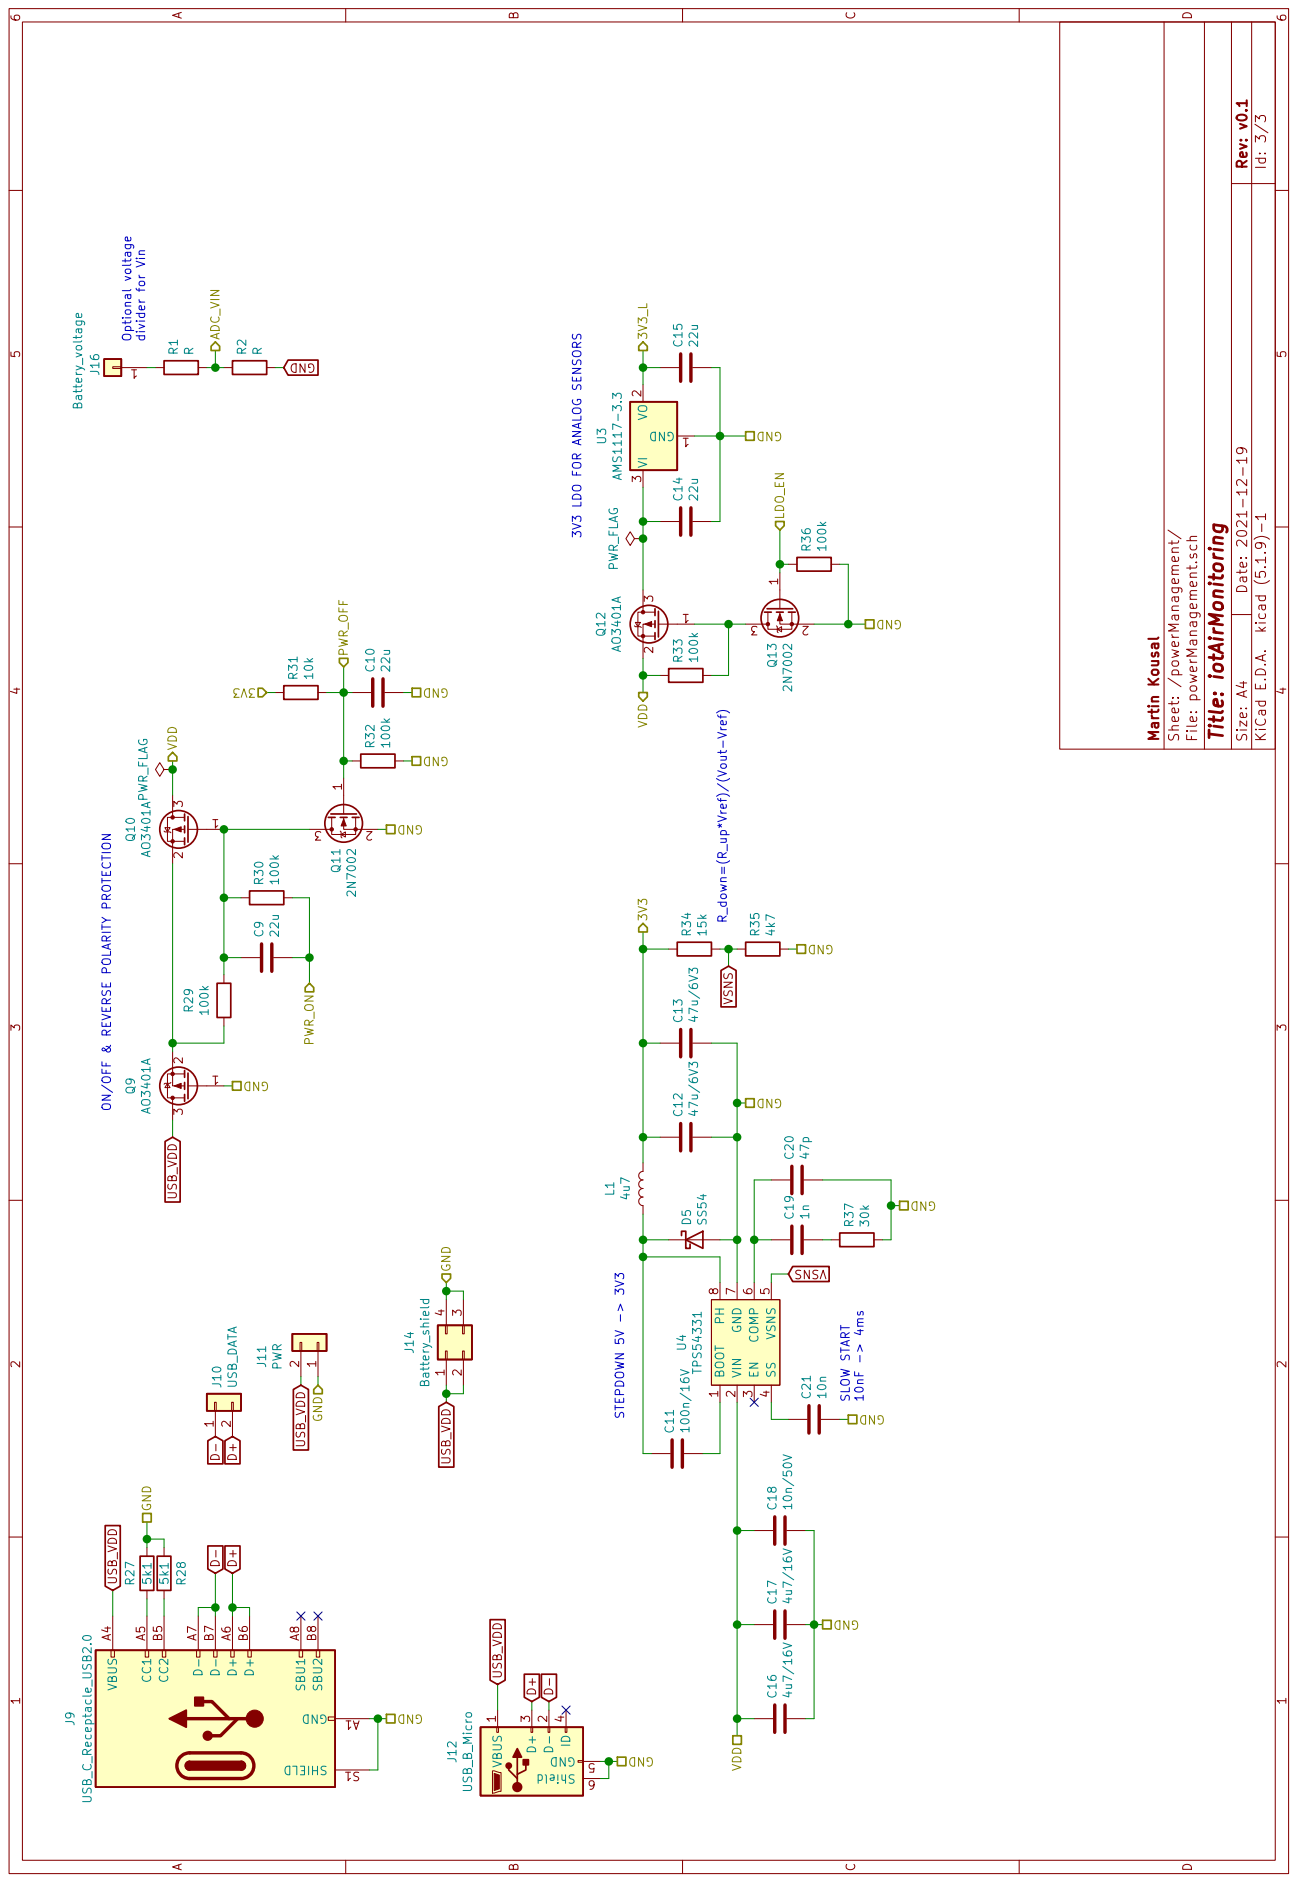
[picture p53: page 3]
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

Id: 3/3 Martin Kousal Sheet: /powerManagement/

divider for Vin STEPDOWN 5V -> 3V3 ON/OFF & REVERSE POLARITY PROTECTION

10nF -> 4ms 3V3 LDO FOR ANALOG SENSORS

VDD GND GND GND

3V3 VDD GND GND GND
