mkousal/bcthesis/text/obrazky/ldo18-schematic.pdf

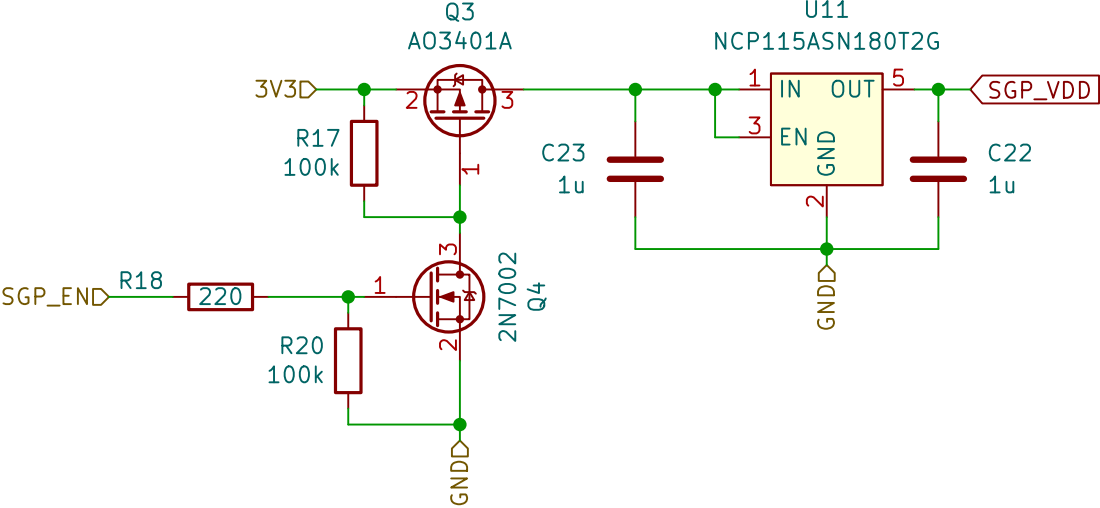
[picture p54: page 1]
