mkousal/bcthesis/text/obrazky/batteryCharger_schematic.pdf

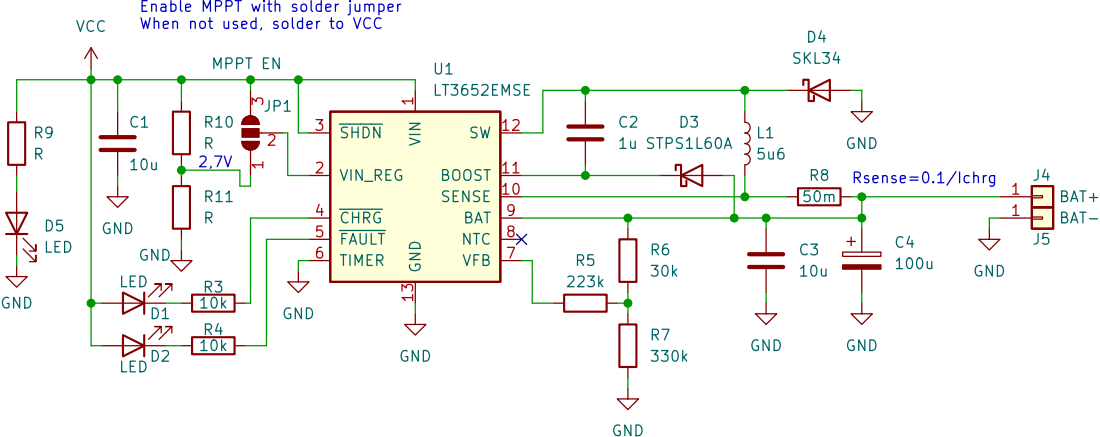
[picture p55: page 1]
