mkousal/bcthesis/text/obrazky/stepup_schematic.pdf

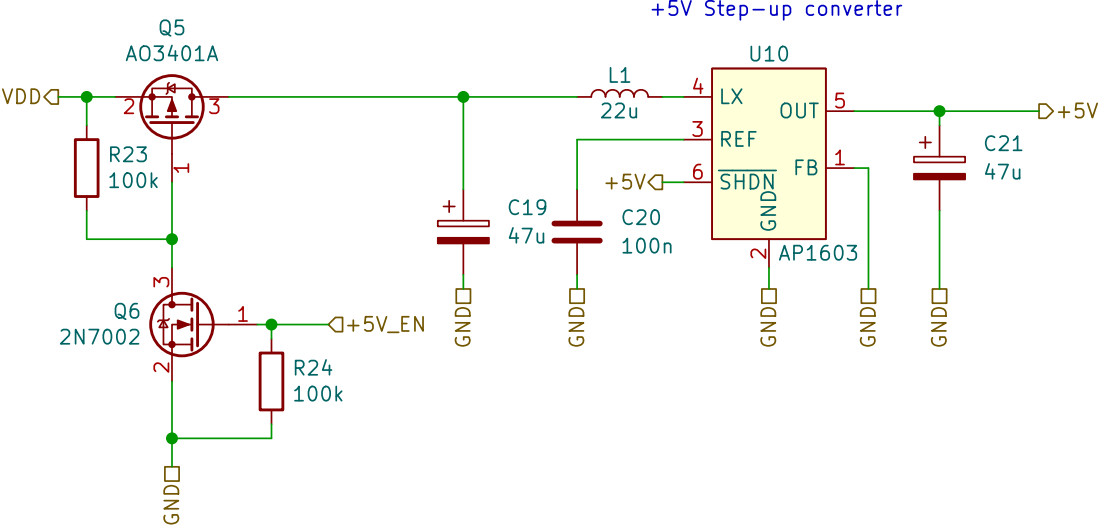
[picture p56: page 1]
