mkousal/bcthesis/text/obrazky/ldo-schematic.pdf

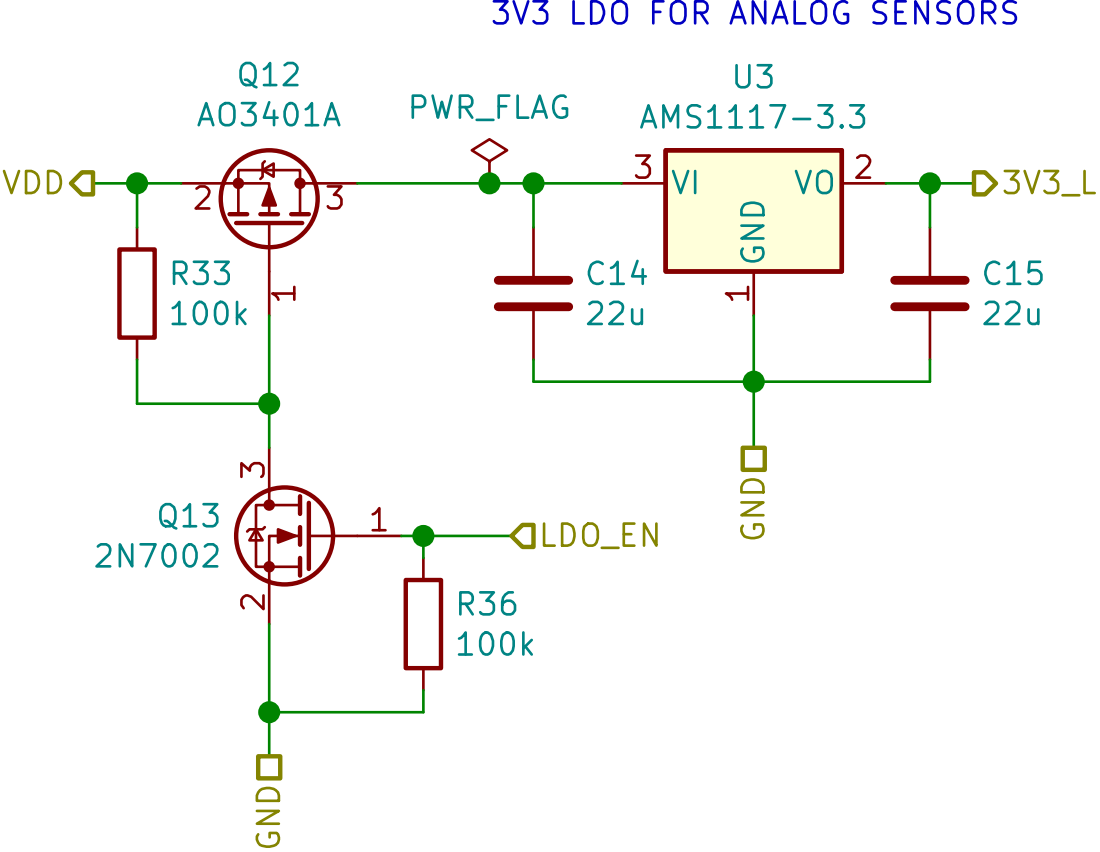
[picture p57: page 1]
