mkousal/bcthesis/text/obrazky/stepdown_schematic.pdf

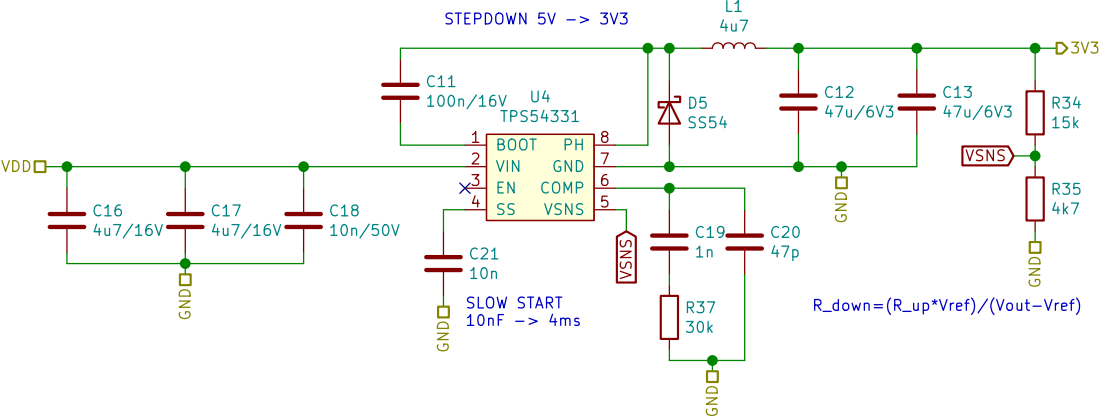
[picture p58: page 1]
