mkousal/bcthesis/text/obrazky/level_shifter.pdf

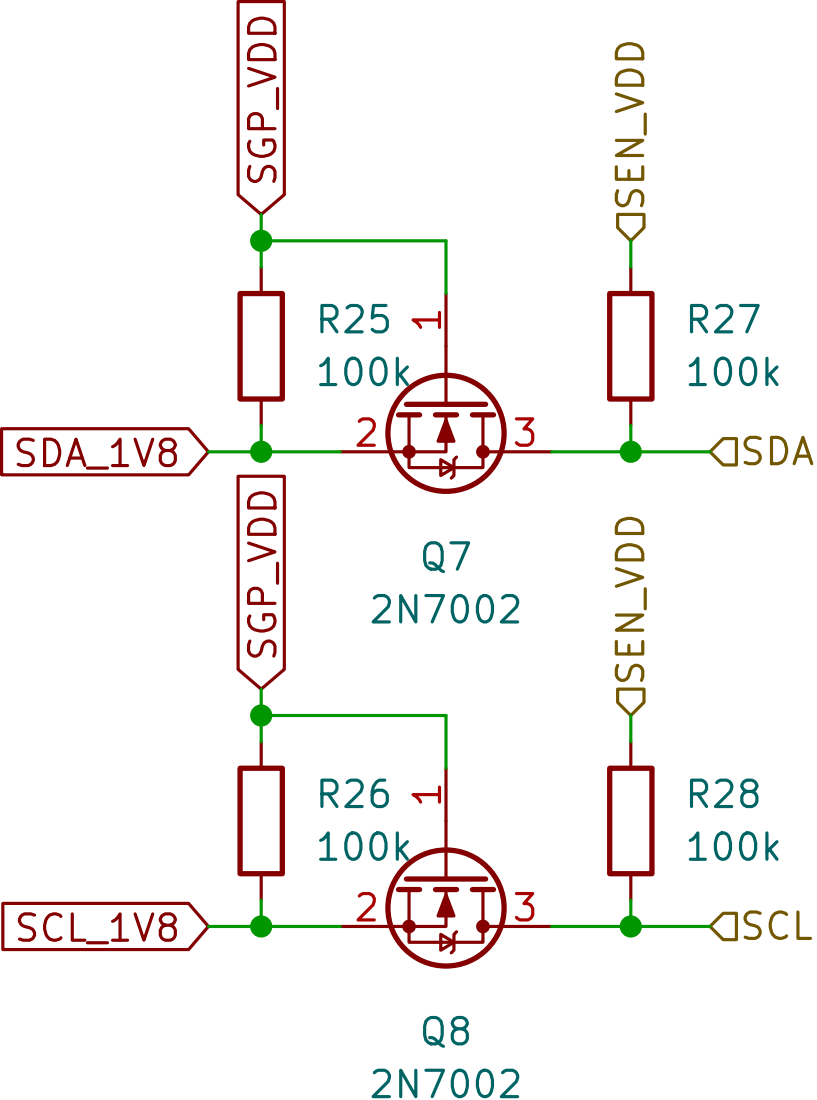
[picture p59: page 1]
