mkousal/bcthesis/text/obrazky/data_flow.pdf

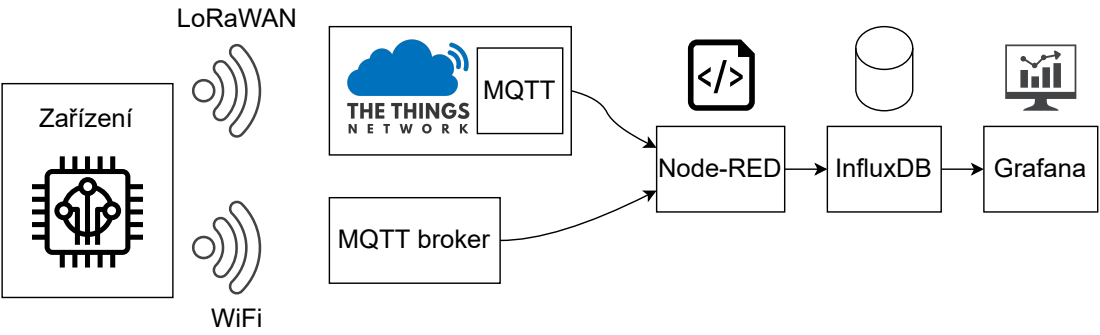
[picture p60: page 1]
Zařízení; LoRaWAN; WiFi; MQTT broker; Node-RED; MQTT; InfluxDB; Grafana
