mkousal/bcthesis/hw/v1.1/mainBoard/mainBoard.kicad_pcb

## KiCad design hw/v1.1/mainBoard/mainBoard.kicad_pcb (2022-05-09)

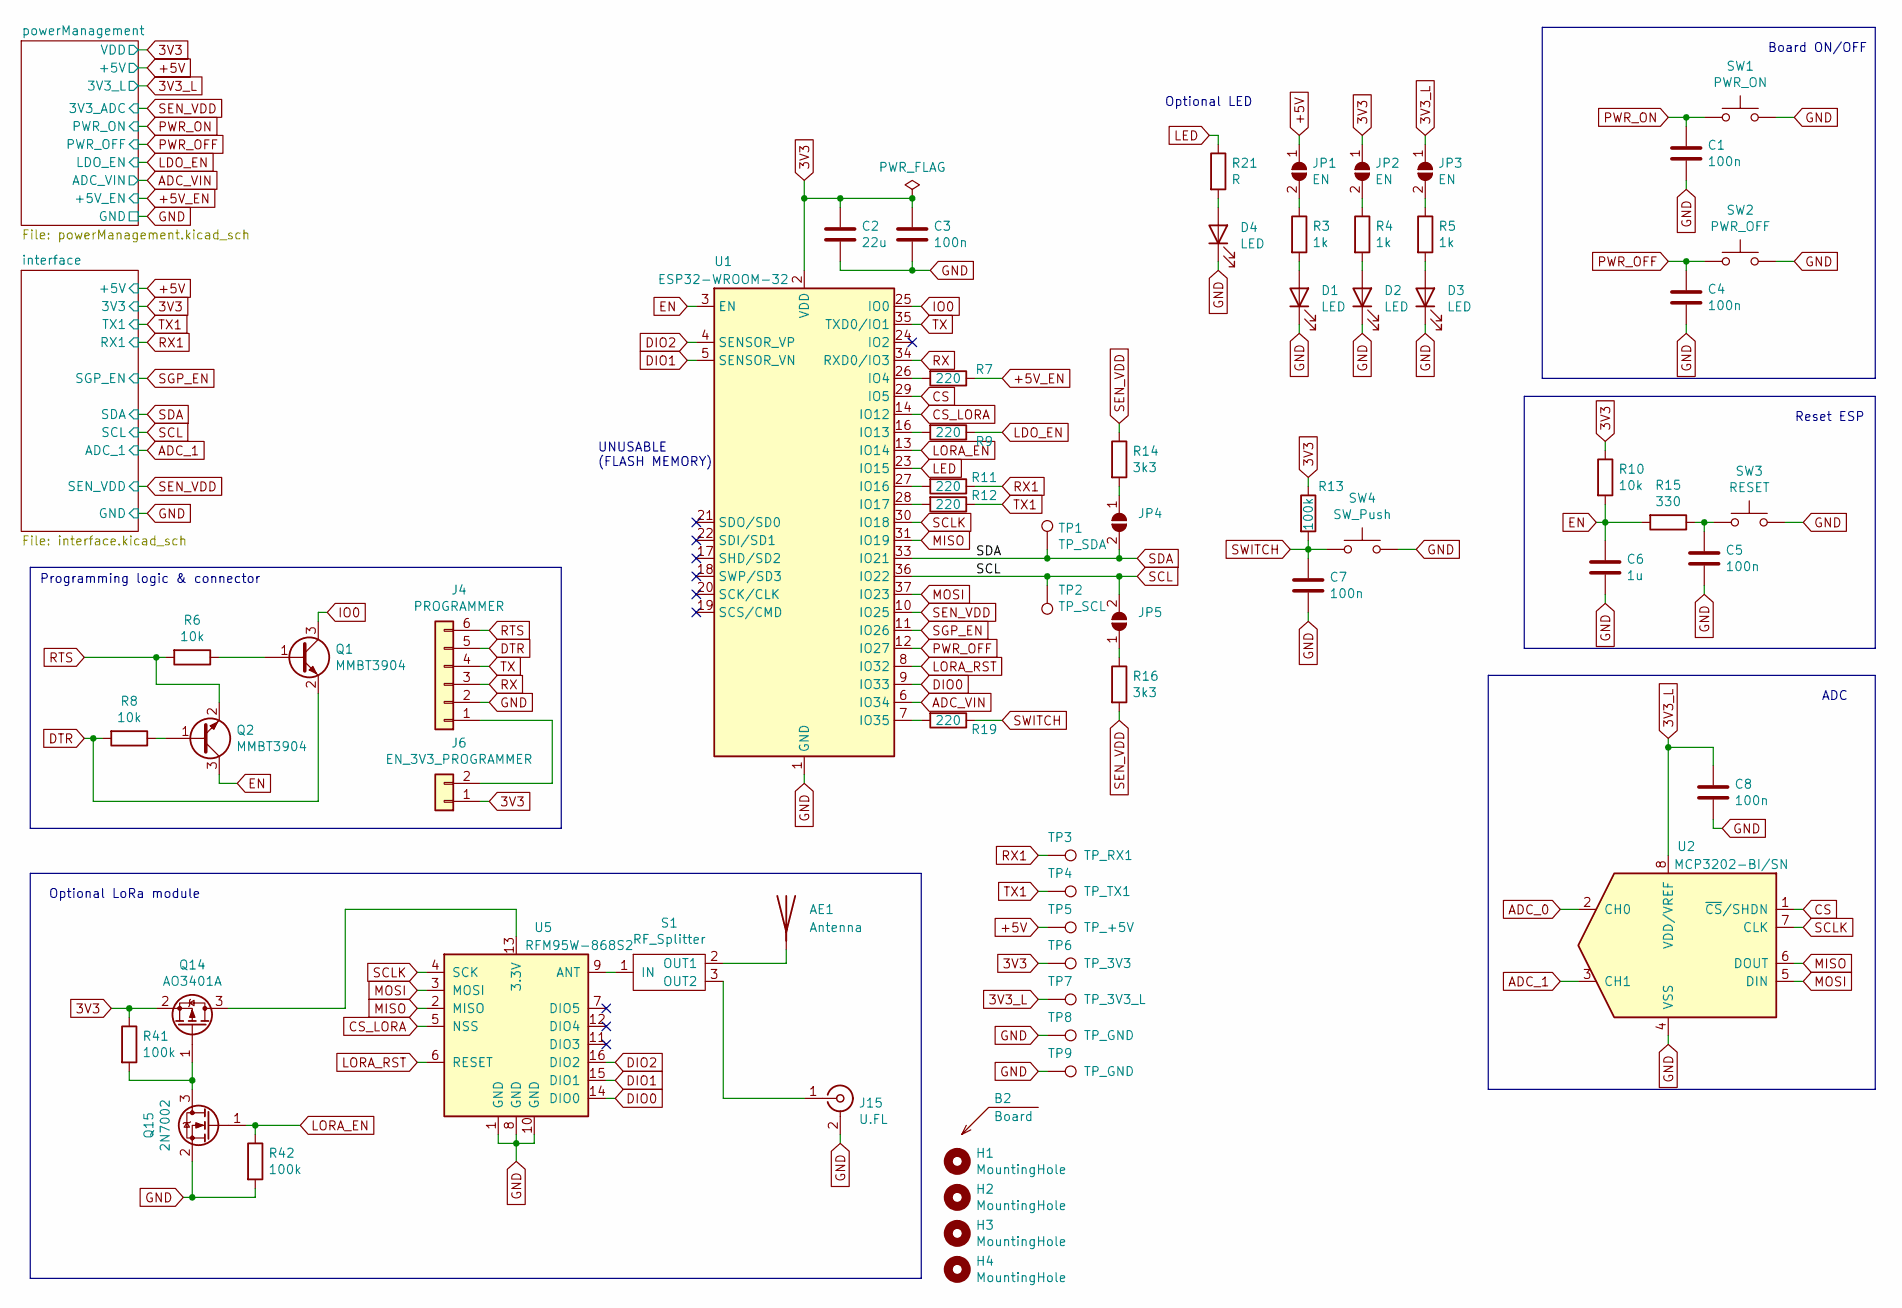
[picture p61: schematic mainBoard.kicad_sch]

Parts:
AE1: Antenna; ANT-868-CHP-T
B2: Board
C1, C3, C4, C5, C7, C8: 100n; C_0603_1608Metric; LCSC C1525
C2: 22u; C_0805_2012Metric; LCSC C45783
C6: 1u; C_0805_2012Metric; LCSC C52923
D1, D2, D3, D4: LED; LED_0805_2012Metric_Pad1.15x1.40mm_HandSolder
H1, H2, H3, H4: MountingHole; MountingHole_3.2mm_M3_Pad_Via
J4: PROGRAMMER; PinHeader_1x06_P2.54mm_Vertical
J6: EN_3V3_PROGRAMMER; PinHeader_1x02_P2.54mm_Vertical
J15: U.FL; U.FL_Hirose_U.FL-R-SMT-1_Vertical
JP1, JP2, JP3: EN; SolderJumper-2_P1.3mm_Open_RoundedPad1.0x1.5mm
JP4, JP5: SolderJumper-2_P1.3mm_Open_TrianglePad1.0x1.5mm
Q1, Q2: MMBT3904; SOT-23; LCSC C20526
Q14: AO3401A; SOT-23; LCSC C15127
Q15: 2N7002; SOT-23; LCSC C8545
R3, R4, R5: 1k; R_0805_2012Metric; LCSC C11702
R6, R8, R10: 10k; R_0805_2012Metric; LCSC C25744
R7, R9, R11, R12, R19: 220; R_0805_2012Metric; LCSC C25091
R13, R41, R42: 100k; R_0805_2012Metric; LCSC C25741
R14, R16: 3k3; R_0805_2012Metric; LCSC C25890
R15: 330; R_0805_2012Metric; LCSC C25104
R21: R; R_0805_2012Metric
S1: RF_Splitter
SW1: PWR_ON; SW_PUSH_6mm
SW2: PWR_OFF; SW_PUSH_6mm
SW3: RESET; SW_PUSH_6mm
SW4: SW_Push; SW_PUSH_6mm
TP1: TP_SDA; TestPoint_Pad_D1.5mm
TP2: TP_SCL; TestPoint_Pad_D1.5mm
TP3: TP_RX1; TestPoint_Pad_D1.5mm
TP4: TP_TX1; TestPoint_Pad_D1.5mm
TP5: TP_+5V; TestPoint_Pad_D1.5mm
TP6: TP_3V3; TestPoint_Pad_D1.5mm
TP7: TP_3V3_L; TestPoint_Pad_D1.5mm
TP8, TP9: TP_GND; TestPoint_Pad_D1.5mm
U1: ESP32-WROOM-32; LCSC C82899
U2: MCP3202-BI/SN; SOIC-8_3.9x4.9mm_P1.27mm
U5: RFM95W-868S2; HOPERF_RFM9XW_SMD

Connections:
3V3: C2.1, C3.1, J6.1, JP2.1 (A), Q14.2 (S), R10.1, R13.1, R41.1, TP6.1, U1.2 (VDD); also elsewhere on the board
3V3_L: C8.1, JP3.1 (A), TP7.1, U2.8 (VDD/VREF); also elsewhere on the board
+5V: JP1.1 (A), TP5.1; also elsewhere on the board
+5V_EN: R7.1; also elsewhere on the board
ADC_0: U2.2 (CH0)
ADC_1: U2.3 (CH1); also elsewhere on the board
ADC_VIN: U1.6 (IO34); also elsewhere on the board
CS: U1.29 (IO5), U2.1 (~CS/SHDN)
CS_LORA: U1.14 (IO12), U5.5 (NSS)
DIO0: U1.9 (IO33), U5.14 (DIO0)
DIO1: U1.5 (SENSOR_VN), U5.15 (DIO1)
DIO2: U1.4 (SENSOR_VP), U5.16 (DIO2)
DTR: J4.5, Q1.2 (E), R8.2
EN: C6.1, Q2.3 (C), R10.2, R15.2, U1.3 (EN)
GND: C1.2, C2.2, C3.2, C4.2, C5.2, C6.2, C7.2, C8.2, D1.1 (K), D2.1 (K), D3.1 (K), D4.1 (K), J4.2, J15.2 (Ext), Q15.2 (S), R42.2, SW1.2, SW2.2, SW3.2, SW4.2, TP8.1, TP9.1, U1.1 (GND), U1.15 (GND), U1.38 (GND), U1.39 (GND), U2.4 (VSS), U5.1 (GND), U5.8 (GND), U5.10 (GND); also elsewhere on the board
IO0: Q1.3 (C), U1.25 (IO0)
LDO_EN: R9.1; also elsewhere on the board
LED: R21.1, U1.23 (IO15)
LORA_EN: Q15.1 (G), R42.1, U1.13 (IO14)
LORA_RST: U1.8 (IO32), U5.6 (RESET)
MISO: U1.31 (IO19), U2.6 (DOUT), U5.2 (MISO)
MOSI: U1.37 (IO23), U2.5 (DIN), U5.3 (MOSI)
unnamed: AE1.1 (A), S1.2 (OUT1)
unnamed: C5.1, R15.1, SW3.1
unnamed: D1.2 (A), R3.2
unnamed: D2.2 (A), R4.2
unnamed: D3.2 (A), R5.2
unnamed: D4.2 (A), R21.2
unnamed: J4.1, J6.2
unnamed: J15.1 (In), S1.3 (OUT2)
unnamed: JP1.2 (B), R3.1
unnamed: JP2.2 (B), R4.1
unnamed: JP3.2 (B), R5.1
unnamed: JP4.1 (A), R14.2
unnamed: JP5.1 (A), R16.1
unnamed: Q1.1 (B), R6.1
unnamed: Q2.1 (B), R8.1
unnamed: Q14.1 (G), Q15.3 (D), R41.2
unnamed: Q14.3 (D), U5.13 (3.3V)
unnamed: R7.2, U1.26 (IO4)
unnamed: R9.2, U1.16 (IO13)
unnamed: R11.2, U1.27 (IO16)
unnamed: R12.2, U1.28 (IO17)
unnamed: R19.2, U1.7 (IO35)
unnamed: S1.1 (IN), U5.9 (ANT)
PWR_OFF: C4.1, SW2.1, U1.12 (IO27); also elsewhere on the board
PWR_ON: C1.1, SW1.1; also elsewhere on the board
RTS: J4.6, Q2.2 (E), R6.2
RX: J4.3, U1.34 (RXD0/IO3)
RX1: R11.1, TP3.1; also elsewhere on the board
SCL: JP5.2 (B), TP2.1, U1.36 (IO22); also elsewhere on the board
SCLK: U1.30 (IO18), U2.7 (CLK), U5.4 (SCK)
SDA: JP4.2 (B), TP1.1, U1.33 (IO21); also elsewhere on the board
SEN_VDD: R14.1, R16.2, U1.10 (IO25); also elsewhere on the board
SGP_EN: U1.11 (IO26); also elsewhere on the board
SWITCH: C7.1, R13.2, R19.1, SW4.1
TX: J4.4, U1.35 (TXD0/IO1)
TX1: R12.1, TP4.1; also elsewhere on the board

Notes on the sheet:
ADC
Programming logic & connector
Reset ESP
Optional LoRa module
UNUSABLE (FLASH MEMORY)
Board ON/OFF
Optional LED

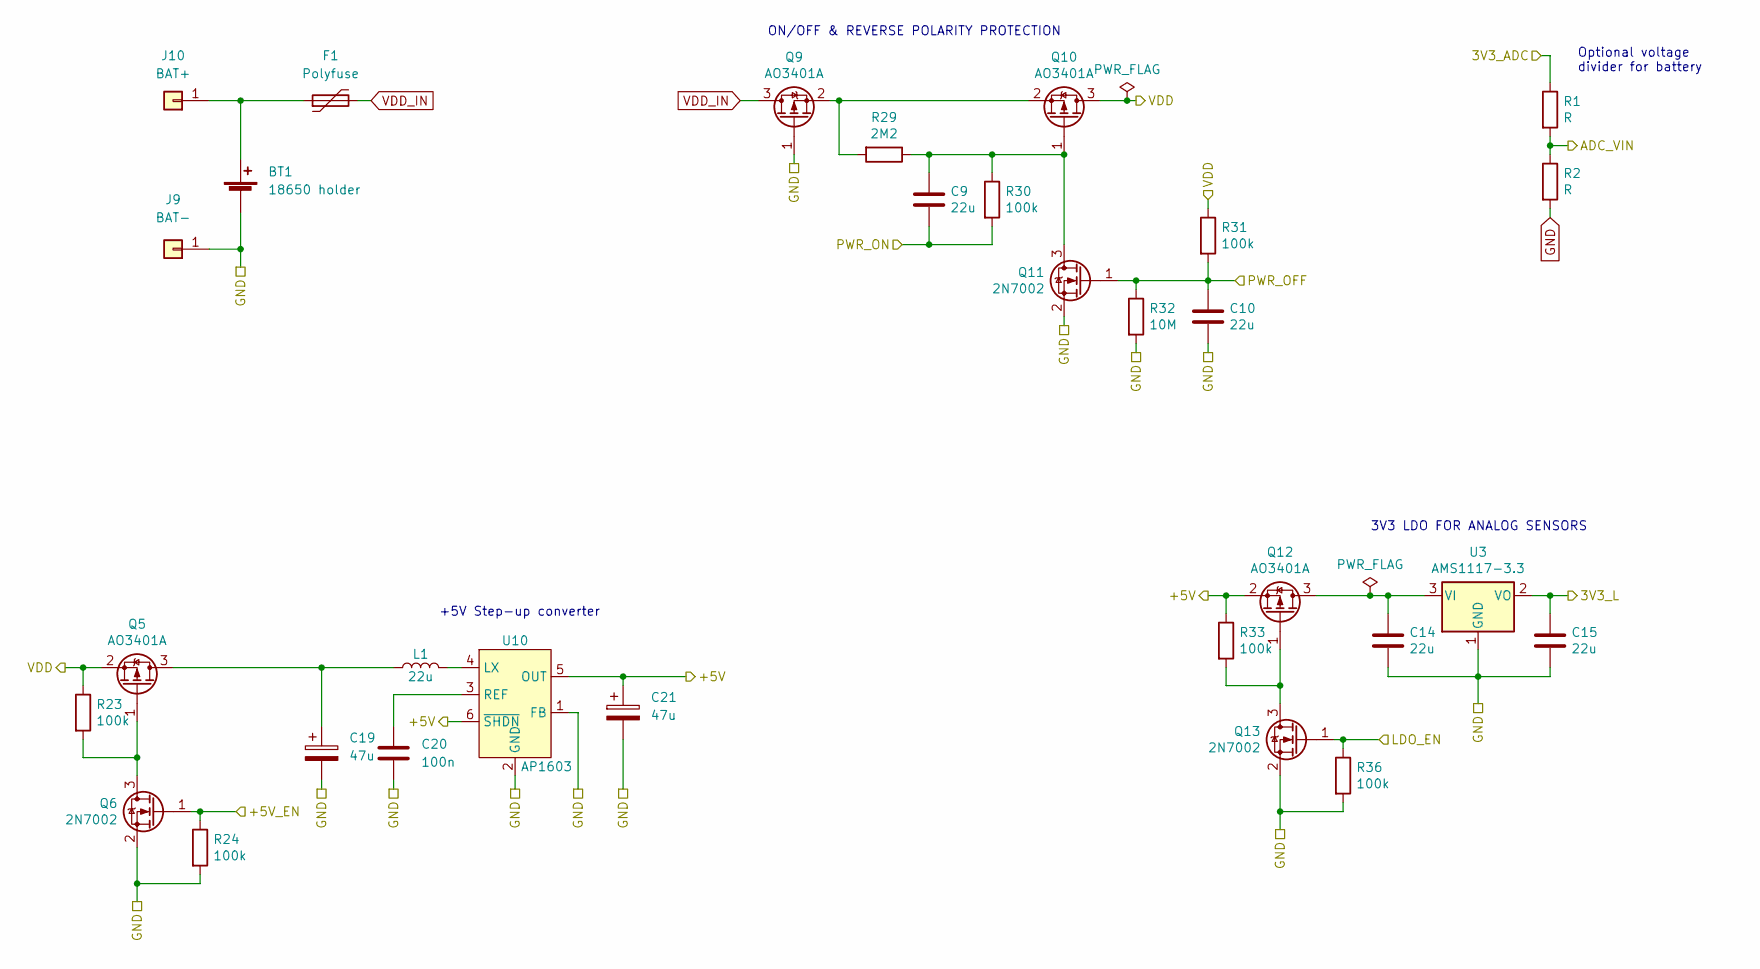
[picture p62: schematic powerManagement.kicad_sch, iotAirMonitoring]

Parts:
BT1: 18650 holder; JST_XH_B2B-XH-A_1x02_P2.50mm_Vertical
C9, C10, C14, C15: 22u; C_0805_2012Metric; LCSC C45783
C19, C21: 47u; CP_Elec_6.3x7.7
C20: 100n; C_0603_1608Metric
F1: Polyfuse; Fuse_1812_4532Metric_Pad1.30x3.40mm_HandSolder
J9: BAT-; 2mm_Banana-Socket
J10: BAT+; 2mm_Banana-Socket
L1: 22u; L_Coilcraft_LPS4018
Q5, Q9, Q10, Q12: AO3401A; SOT-23; LCSC C15127
Q6, Q11, Q13: 2N7002; SOT-23; LCSC C8545
R1, R2: R; R_0805_2012Metric_Pad1.20x1.40mm_HandSolder
R23, R24, R30, R33, R36: 100k; R_0805_2012Metric; LCSC C25741
R29: 2M2; R_0805_2012Metric; LCSC C25741
R31: 100k; R_0805_2012Metric; LCSC C25744
R32: 10M; R_0805_2012Metric; LCSC C25741
U3: AMS1117-3.3; SOT-223-3_TabPin2; LCSC C6186
U10: AP1603; SOT-23-6_Handsoldering

Connections:
3V3: Q5.2 (S), Q10.3 (D), R23.1, R31.1; also elsewhere on the board
3V3_L: C15.1, U3.2 (VO); also elsewhere on the board
+5V: C21.1, Q12.2 (S), R33.1, U10.5 (OUT), U10.6 (~SHDN); also elsewhere on the board
+5V_EN: Q6.1 (G), R24.1; also elsewhere on the board
ADC_VIN: R1.2, R2.1; also elsewhere on the board
GND: BT1.2 (-), C10.2, C14.2, C15.2, C19.2, C20.2, C21.2, J9.1, Q6.2 (S), Q9.1 (G), Q11.2 (S), Q13.2 (S), R2.2, R24.2, R32.2, R36.2, U3.1 (GND), U10.1 (FB), U10.2 (GND); also elsewhere on the board
LDO_EN: Q13.1 (G), R36.1; also elsewhere on the board
unnamed: BT1.1 (+), F1.1, J10.1
unnamed: C9.1, Q10.1 (G), Q11.3 (D), R29.1, R30.1
unnamed: C14.1, Q12.3 (D), U3.3 (VI)
unnamed: C19.1, L1.1, Q5.3 (D)
unnamed: C20.1, U10.3 (REF)
unnamed: L1.2, U10.4 (LX)
unnamed: Q5.1 (G), Q6.3 (D), R23.2
unnamed: Q9.2 (S), Q10.2 (S), R29.2
unnamed: Q12.1 (G), Q13.3 (D), R33.2
PWR_OFF: C10.1, Q11.1 (G), R31.2, R32.1; also elsewhere on the board
PWR_ON: C9.2, R30.2; also elsewhere on the board
SEN_VDD: R1.1; also elsewhere on the board
VDD_IN: F1.2, Q9.3 (D)

Notes on the sheet:
Optional voltage divider for battery
+5V Step-up converter
ON/OFF & REVERSE POLARITY PROTECTION
3V3 LDO FOR ANALOG SENSORS

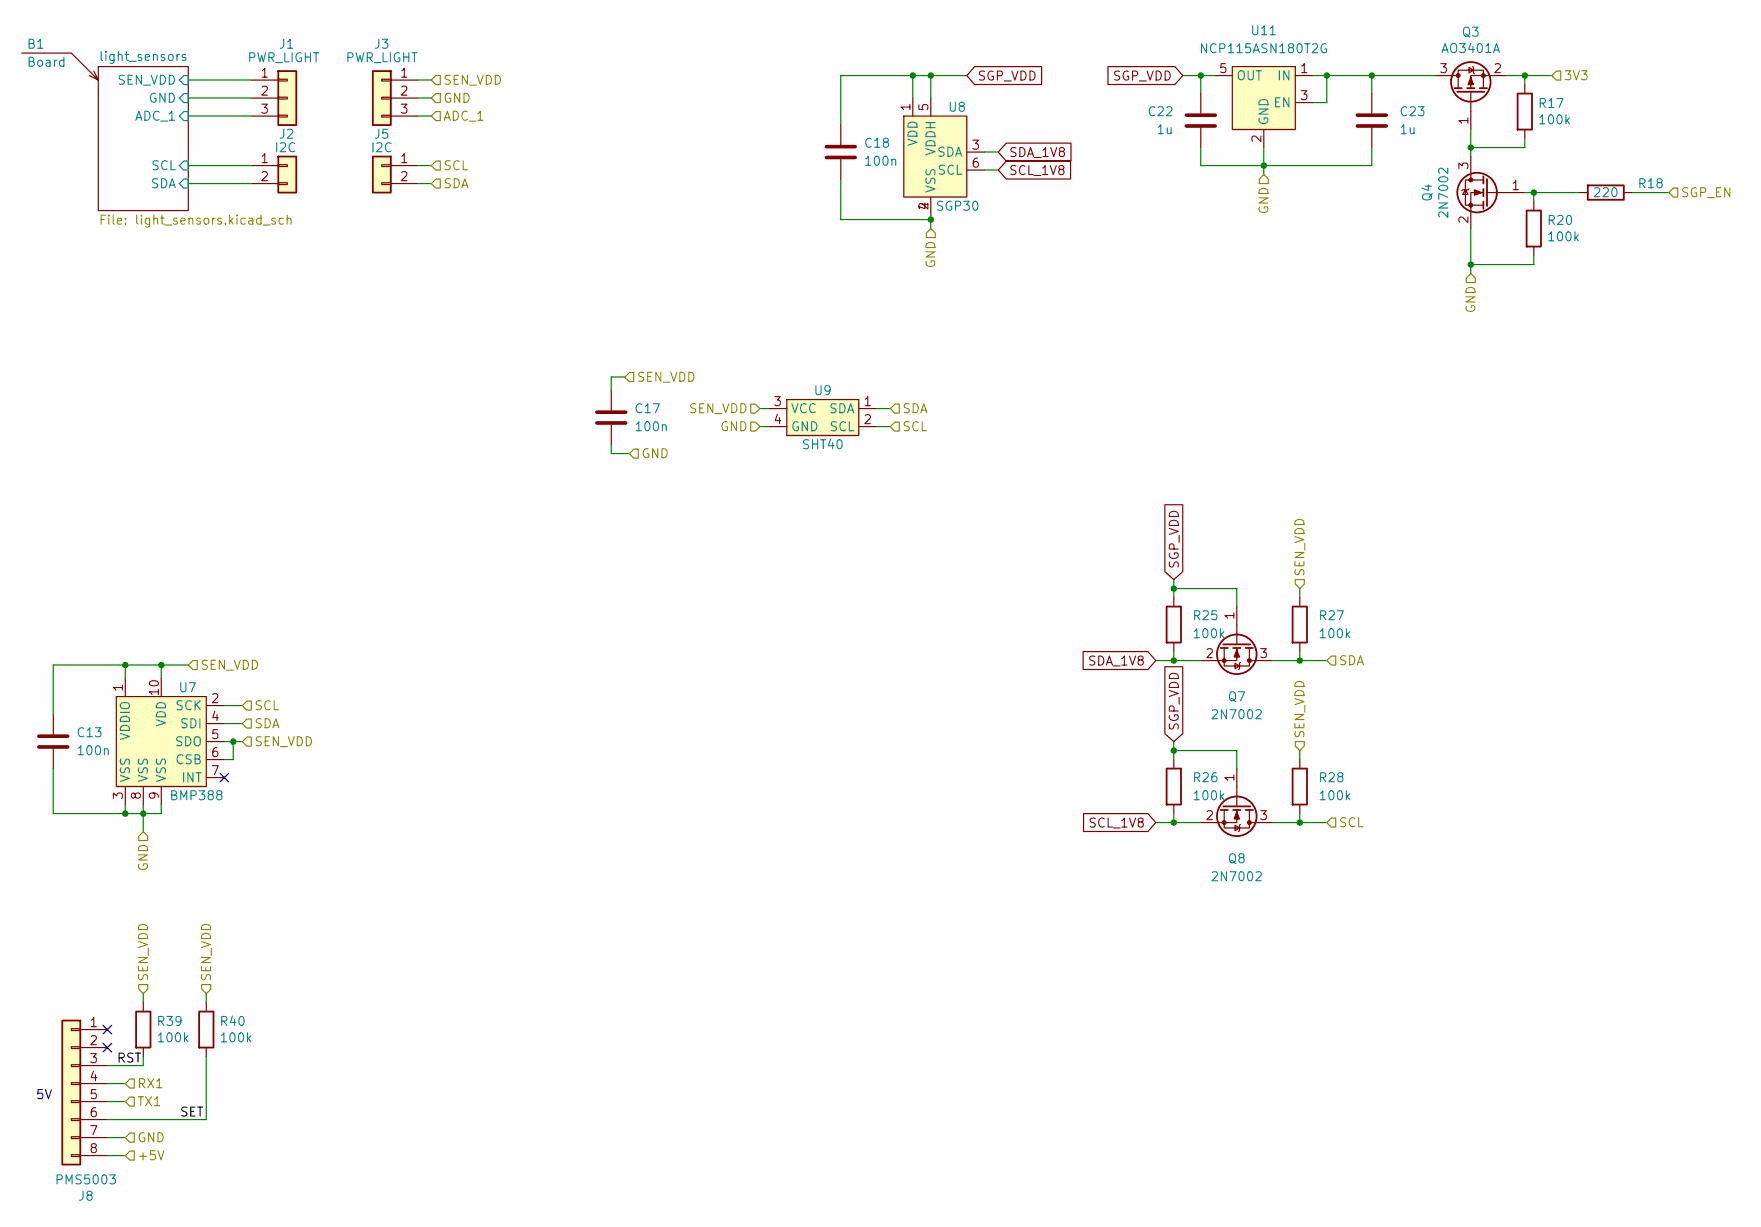
[picture p63: schematic interface.kicad_sch, iotAirMonitoring]

Parts:
B1: Board
C13, C17, C18: 100n; C_0603_1608Metric
C22, C23: 1u; C_0805_2012Metric
J1: PWR_LIGHT; PinHeader_1x03_P2.54mm_Vertical
J2: I2C; PinHeader_1x02_P2.54mm_Vertical
J3: PWR_LIGHT; PinSocket_1x03_P2.54mm_Vertical
J5: I2C; PinSocket_1x02_P2.54mm_Vertical
J8: PMS5003; Molex_PicoBlade_53048-0810_1x08_P1.25mm_Horizontal
Q3: AO3401A; SOT-23; LCSC C15127
Q4: 2N7002; SOT-23; LCSC C8545
Q7, Q8: 2N7002; SOT-23
R17, R20, R39, R40: 100k; R_0805_2012Metric; LCSC C25741
R18: 220; R_0805_2012Metric; LCSC C25091
R25, R26, R27, R28: 100k; R_0805_2012Metric
U7: BMP388
U8: SGP30
U9: SHT40
U11: NCP115ASN180T2G; TSOP-5_1.65x3.05mm_P0.95mm

Connections:
3V3: Q3.2 (S), R17.1; also elsewhere on the board
+5V: J8.8; also elsewhere on the board
/interface/RST: J8.3, R39.2
/interface/SET: J8.6, R40.2
/interface/light_sensors/ADC_1: J1.3; also elsewhere on the board
/interface/light_sensors/GND: J1.2; also elsewhere on the board
/interface/light_sensors/SCL: J2.1; also elsewhere on the board
/interface/light_sensors/SDA: J2.2; also elsewhere on the board
/interface/light_sensors/SEN_VDD: J1.1; also elsewhere on the board
ADC_1: J3.3; also elsewhere on the board
GND: C13.2, C17.2, C18.2, C22.2, C23.2, J3.2, J8.7, Q4.2 (S), R20.2, U7.3 (VSS), U7.8 (VSS), U7.9 (VSS), U8.2 (VSS), U8.4, U9.4 (GND), U11.2 (GND); also elsewhere on the board
unnamed: C23.1, Q3.3 (D), U11.1 (IN), U11.3 (EN)
unnamed: Q3.1 (G), Q4.3 (D), R17.2
unnamed: Q4.1 (G), R18.2, R20.1
RX1: J8.4; also elsewhere on the board
SCL: J5.1, Q8.3 (D), R28.2, U7.2 (SCK), U9.2 (SCL); also elsewhere on the board
SCL_1V8: Q8.2 (S), R26.2, U8.6 (SCL)
SDA: J5.2, Q7.3 (D), R27.2, U7.4 (SDI), U9.1 (SDA); also elsewhere on the board
SDA_1V8: Q7.2 (S), R25.2, U8.3 (SDA)
SEN_VDD: C13.1, C17.1, J3.1, R27.1, R28.1, R39.1, R40.1, U7.1 (VDDIO), U7.5 (SDO), U7.6 (CSB), U7.10 (VDD), U9.3 (VCC); also elsewhere on the board
SGP_EN: R18.1; also elsewhere on the board
SGP_VDD: C18.1, C22.1, Q7.1 (G), Q8.1 (G), R25.1, R26.1, U8.1 (VDD), U8.5 (VDDH), U11.5 (OUT)
TX1: J8.5; also elsewhere on the board

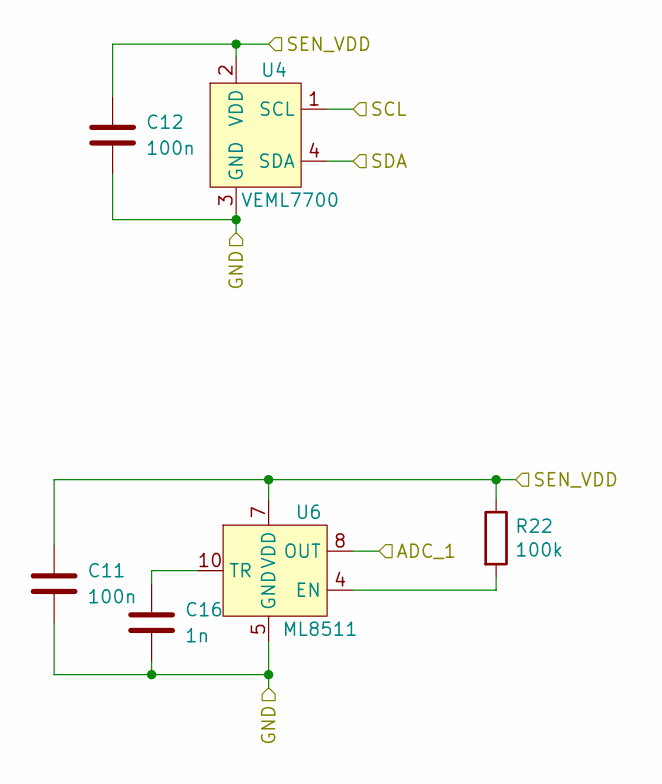
[picture p64: schematic light_sensors.kicad_sch]

Parts:
C11, C12: 100n; C_0603_1608Metric
C16: 1n; C_0805_2012Metric
R22: 100k; R_0805_2012Metric; LCSC C25741
U4: VEML7700
U6: ML8511

Connections:
/interface/light_sensors/ADC_1: U6.8 (OUT); also elsewhere on the board
/interface/light_sensors/GND: C11.2, C12.2, C16.2, U4.3 (GND), U6.5 (GND); also elsewhere on the board
/interface/light_sensors/SCL: U4.1 (SCL); also elsewhere on the board
/interface/light_sensors/SDA: U4.4 (SDA); also elsewhere on the board
/interface/light_sensors/SEN_VDD: C11.1, C12.1, R22.1, U4.2 (VDD), U6.7 (VDD); also elsewhere on the board
unnamed: C16.1, U6.10 (TR)
unnamed: R22.2, U6.4 (EN)

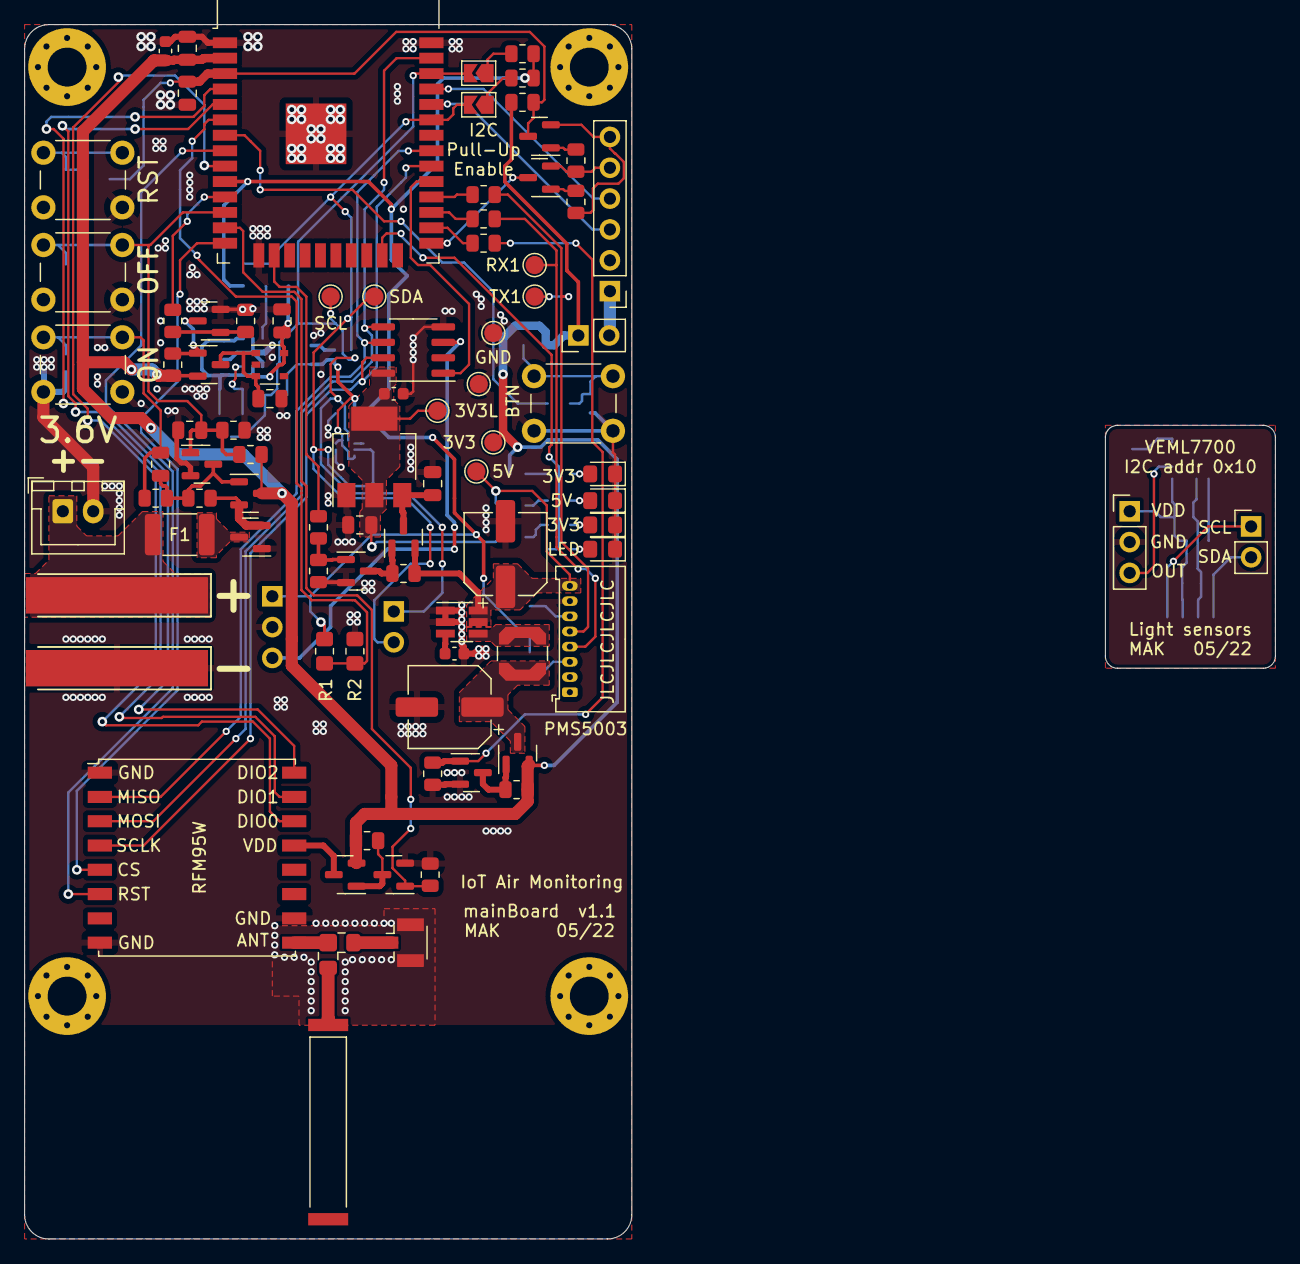
[picture p65: board mainBoard.kicad_pcb from above]

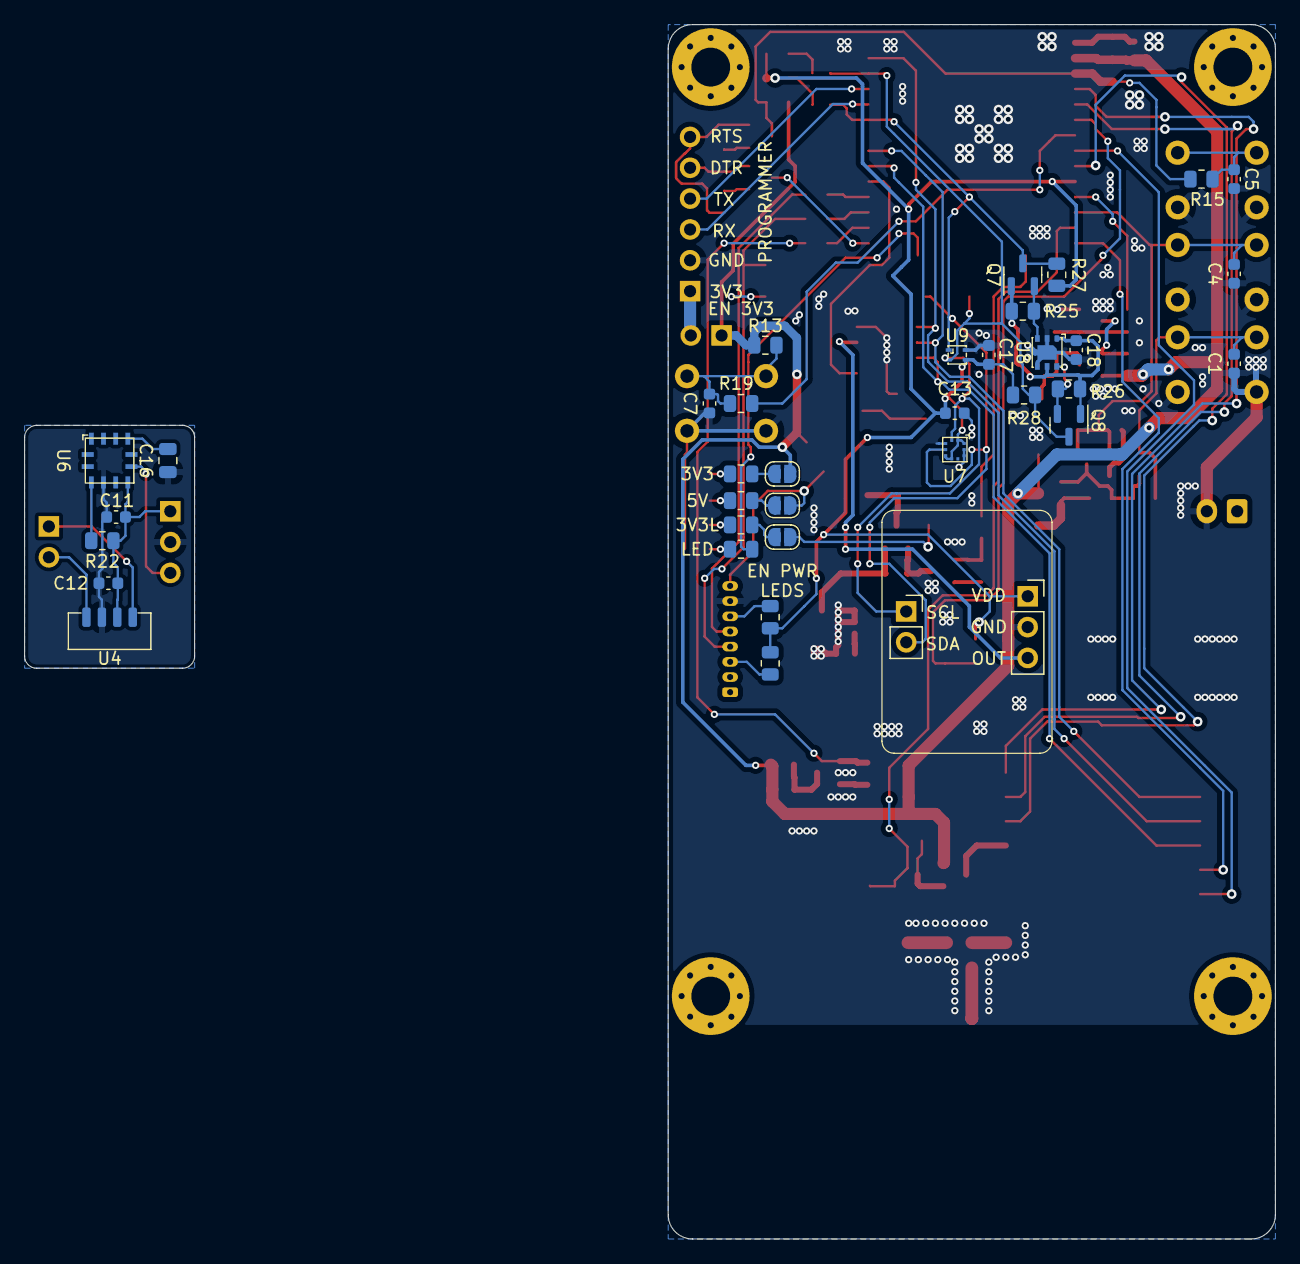
[picture p66: board mainBoard.kicad_pcb from below]

Board: 2 copper layers, 50.0 x 100.0 mm, 130 parts (36 on the bottom side), 82 nets.
