mkousal/bcthesis/hw/v1.0/batteryCharger/batteryCharger.kicad_pcb

## KiCad design hw/v1.0/batteryCharger/batteryCharger.kicad_pcb (2022-03-06, an earlier design)

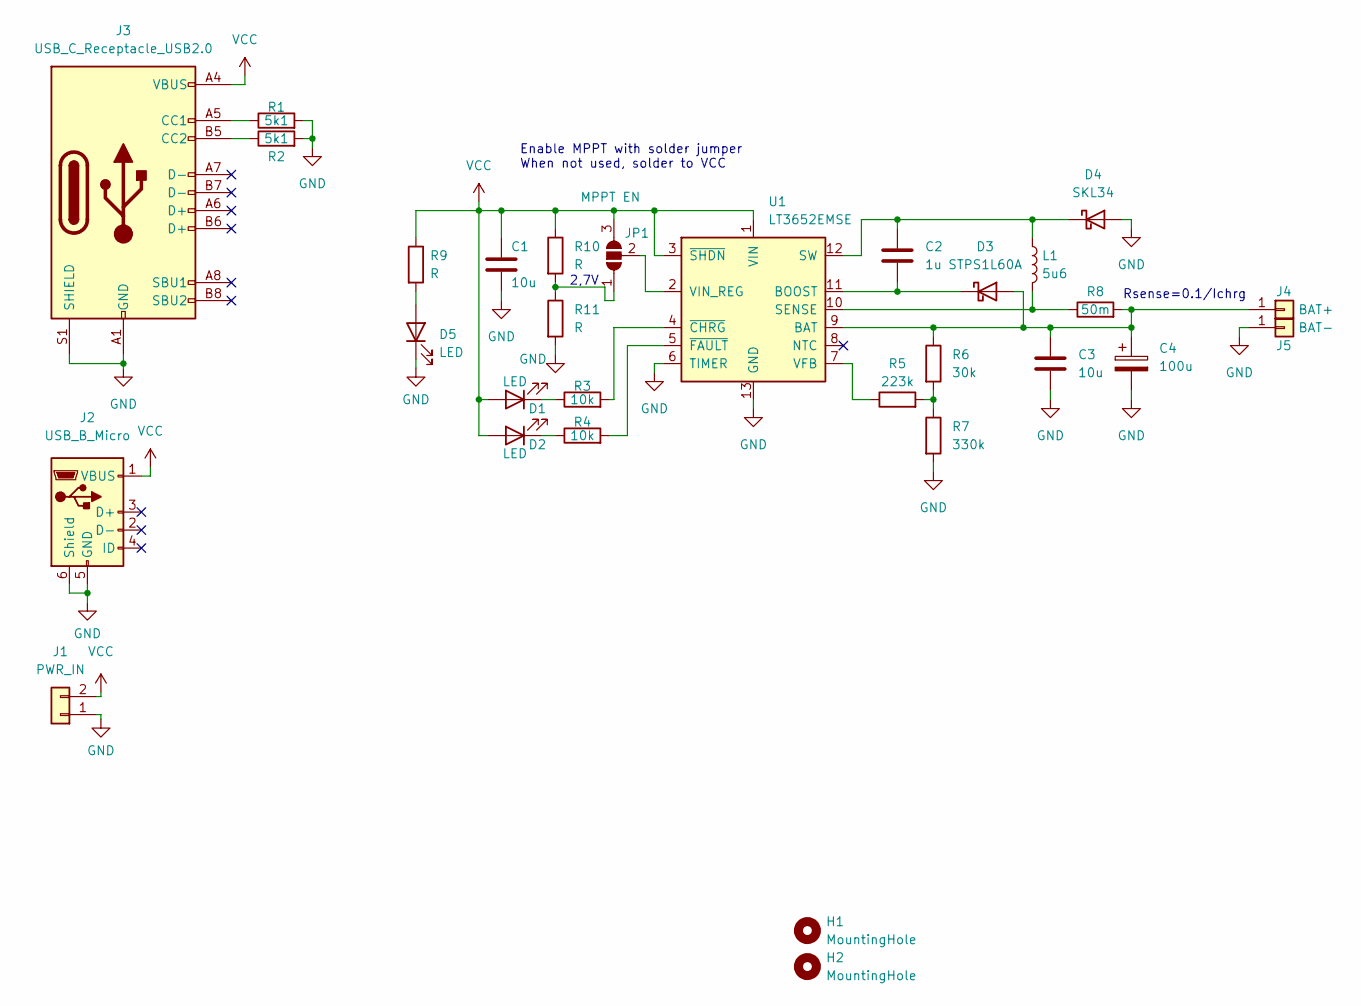
[picture p67: schematic batteryCharger.kicad_sch]

Parts:
C1, C3: 10u; C_0805_2012Metric_Pad1.18x1.45mm_HandSolder
C2: 1u; C_0805_2012Metric_Pad1.18x1.45mm_HandSolder
C4: 100u; CP_Radial_D6.3mm_P2.50mm
D1, D2, D5: LED; LED_0805_2012Metric_Pad1.15x1.40mm_HandSolder
D3: STPS1L60A; D_SMA_Handsoldering
D4: SKL34; D_SOD-123F
H1, H2: MountingHole; MountingHole_3.2mm_M3_Pad_Via
J1: PWR_IN; PinHeader_1x02_P2.54mm_Vertical
J2: USB_B_Micro; USB_Micro-B_Amphenol_10118194_Horizontal
J3: USB_C_Receptacle_USB2.0; USB_C_Receptacle_HRO_TYPE-C-31-M-12
J4: BAT+; 2mm_Banana-Plug
J5: BAT-; 2mm_Banana-Plug
JP1: MPPT EN; SolderJumper-3_P1.3mm_Open_RoundedPad1.0x1.5mm_NumberLabels
L1: 5u6; L_12x12mm_H8mm
R1, R2: 5k1; R_0805_2012Metric_Pad1.20x1.40mm_HandSolder
R3, R4: 10k; R_0805_2012Metric_Pad1.20x1.40mm_HandSolder
R5: 223k; R_0805_2012Metric_Pad1.20x1.40mm_HandSolder
R6: 30k; R_0805_2012Metric_Pad1.20x1.40mm_HandSolder
R7: 330k; R_0805_2012Metric_Pad1.20x1.40mm_HandSolder
R8: 50m; R_1206_3216Metric_Pad1.30x1.75mm_HandSolder
R9, R10, R11: R; R_0805_2012Metric_Pad1.20x1.40mm_HandSolder
U1: LT3652EMSE; MSOP-12-1EP_3x4mm_P0.65mm_EP1.65x2.85mm

Connections:
GND: C1.2, C3.2, C4.2, D4.2 (A), D5.1 (K), J1.1, J2.5 (GND), J2.6 (Shield), J3.A1 (GND), J3.A12 (GND), J3.B1 (GND), J3.B12 (GND), J3.S1 (SHIELD), J5.1, R1.2, R2.2, R7.2, R11.2, U1.6 (TIMER), U1.13 (GND)
unnamed: C2.1, D4.1 (K), L1.1, U1.12 (SW)
unnamed: C2.2, D3.1 (K), U1.11 (BOOST)
unnamed: C3.1, C4.1, D3.2 (A), J4.1, R6.1, R8.2, U1.9 (BAT)
unnamed: D1.1 (K), R3.1
unnamed: D2.1 (K), R4.1
unnamed: D5.2 (A), R9.2
unnamed: J3.A5 (CC1), R1.1
unnamed: J3.B5 (CC2), R2.1
unnamed: JP1.1 (A), R10.2, R11.1
unnamed: JP1.2 (C), U1.2 (VIN_REG)
unnamed: L1.2, R8.1, U1.10 (SENSE)
unnamed: R3.2, U1.4 (~CHRG)
unnamed: R4.2, U1.5 (~FAULT)
unnamed: R5.1, U1.7 (VFB)
unnamed: R5.2, R6.2, R7.1
VCC: C1.1, D1.2 (A), D2.2 (A), J1.2, J2.1 (VBUS), J3.A4 (VBUS), J3.A9 (VBUS), J3.B4 (VBUS), J3.B9 (VBUS), JP1.3 (B), R9.1, R10.1, U1.1 (VIN), U1.3 (~SHDN)

Notes on the sheet:
Rsense=0.1/Ichrg
2,7V
Enable MPPT with solder jumper When not used, solder to VCC

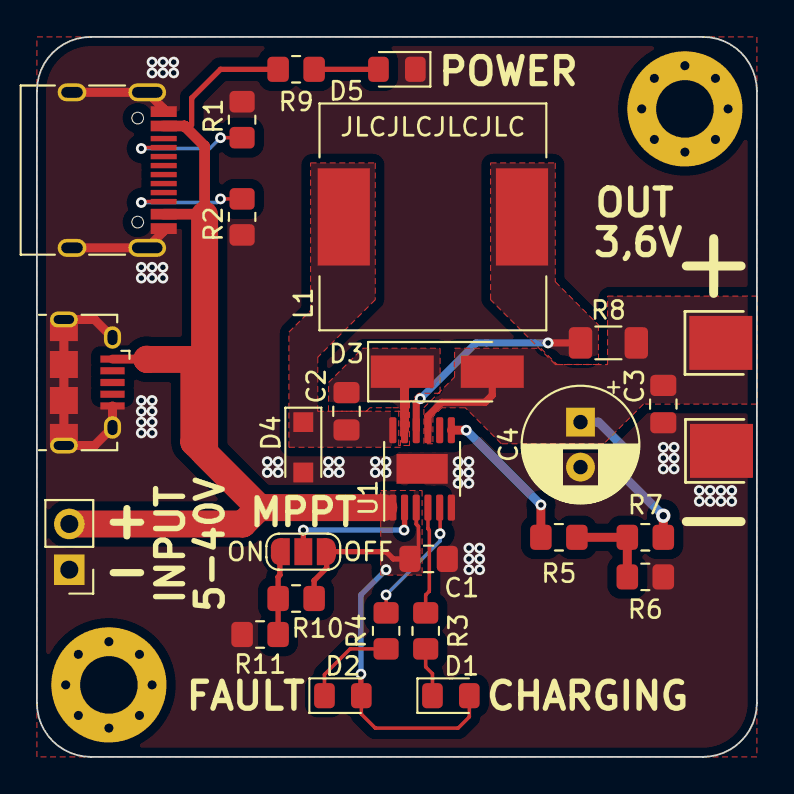
[picture p68: board batteryCharger.kicad_pcb from above]

Board: 2 copper layers, 40.0 x 40.0 mm, 30 parts (0 on the bottom side), 17 nets.
