mkousal/bcthesis/fw/main_project/components/AirMonitoring/AirMonitoring_power.cpp

#include "AirMonitoring_power.hpp"

#include "AirMonitoring_pinout.hpp"

#include <driver/gpio.h>

namespace Am {

Power::Power() {       // Constructor, set default state of power stages
    gpio_config_t io_conf = {};
    io_conf.intr_type = GPIO_INTR_DISABLE;
    io_conf.mode = GPIO_MODE_OUTPUT;
    io_conf.pin_bit_mask = (1<<LDO_EN) | (1<<LORA_EN) | (1<<SGP_EN) | (1<<PMS_EN) | (1<<SEN_VDD_EN) | (1<<LED);
    io_conf.pull_down_en = GPIO_PULLDOWN_DISABLE;
    io_conf.pull_up_en = GPIO_PULLUP_DISABLE;
    gpio_config(&io_conf);
}

Power::~Power() {}

void Power::ldo(bool state){
    gpio_set_level(LDO_EN, state);
}

void Power::sensors(bool state){
    gpio_set_level(SEN_VDD_EN, state);
}

void Power::lora(bool state){
    gpio_set_level(LORA_EN, state);
}

void Power::sgp30(bool state){
    gpio_set_level(SGP_EN, state);
}

void Power::pms(bool state){
    gpio_set_level(PMS_EN, state);
}

void Power::device(bool state){
    gpio_set_direction(POWER_OFF, GPIO_MODE_OUTPUT);
    gpio_set_level(POWER_OFF, state);
}

void Power::isolateGPIO() {
    rtc_gpio_isolate(SEN_VDD_EN);
    rtc_gpio_isolate(LORA_EN);
    rtc_gpio_isolate(LED);
    // rtc_gpio_isolate(PMS_EN);
    // rtc_gpio_isolate(LDO_EN);
    // rtc_gpio_isolate(IO26);
    rtc_gpio_isolate(SWITCH);   
    rtc_gpio_isolate(GPIO_NUM_0);
}

void Power::goToSleep(int time) {
    isolateGPIO();
    // esp_sleep_pd_config(ESP_PD_DOMAIN_RTC_SLOW_MEM, ESP_PD_OPTION_ON);
    // esp_sleep_pd_config(ESP_PD_DOMAIN_RTC_FAST_MEM, ESP_PD_OPTION_ON);
    // esp_sleep_pd_config(ESP_PD_DOMAIN_RTC_PERIPH, ESP_PD_OPTION_ON);
    // esp_sleep_pd_config(ESP_PD_DOMAIN_XTAL, ESP_PD_OPTION_OFF);
    vTaskDelay(10 / portTICK_RATE_MS);
    esp_deep_sleep(time * 60 * 1000 * 1000);
}

} // namespace Am
