mkousal/bcthesis/(commit log)

2021-10-25 Create KiCad project
    [iotAirMonitoring.kicad_pcb, iotAirMonitoring.sch]
2021-10-25 Add on/off and reverse polarity protection circuit, start draw step-down
    [iotAirMonitoring.sch, powerManagement.sch]
2021-10-25 Finish stepdown schematic
    [iotAirMonitoring.sch, powerManagement.sch]
2021-10-26 Add LDO regulator and ESP32
    [iotAirMonitoring.sch, powerManagement.sch]
2021-10-27 More work on schematic
    [iotAirMonitoring.kicad_pcb, iotAirMonitoring.sch]
2021-10-28 Add way more parts to schematic
    [iotAirMonitoring.sch, powerManagement.sch]
2021-10-29 Schematic nearly finished
    [iotAirMonitoring.kicad_pcb, iotAirMonitoring.sch, powerManagement.sch]
2021-10-29 Nearly finished schematic, add optional LoRa module
    [interface.sch, iotAirMonitoring.sch, powerManagement.sch]
2021-10-30 Start routing main board
    [iotAirMonitoring.kicad_pcb]
2021-10-31 More component placement
    [iotAirMonitoring.kicad_pcb]
2021-11-01 Nearly finished component placement
    [iotAirMonitoring.kicad_pcb]
2021-11-01 Start routing of main board
    [iotAirMonitoring.kicad_pcb, powerManagement.sch]
2021-11-01 More routing on main board
    [interface.sch, iotAirMonitoring.kicad_pcb, iotAirMonitoring.sch, powerManagement.sch]
2021-11-02 First version routed main board
    [iotAirMonitoring.kicad_pcb, iotAirMonitoring.sch, powerManagement.sch]
2021-11-02 Add TestPads, improve silkscreen
    [iotAirMonitoring.kicad_pcb, iotAirMonitoring.sch]
2021-11-02 Create Makefile for gerbers generation, type in missing LCSC codes
    [interface.sch, iotAirMonitoring.sch, powerManagement.sch]
2021-11-03 Add JLCPCB assembly correction, generate gerber data
    [interface.sch, iotAirMonitoring.kicad_pcb, iotAirMonitoring.sch, powerManagement.sch]
2021-11-15 Start temperature section
2021-11-20 Add first type of sensor
2021-11-20 Add reference to table in chapter with dust sensors
2021-11-20 Add dust sensor selection text
2021-11-21 Add image of PMS5003 sensor and add sources reference
2021-11-29 Add section sensor of carbon monoxide
2021-11-30 Add UV sensor selection section
2021-12-01 Add temperature sensor choice chapter and sources
2021-12-05 Add section with final selection of temperature sensor and its image
2021-12-06 Add section with light intensity sensor selection
2021-12-07 Add some text to section about selecting atmospheric pressure sensor
2021-12-07 Add text section with selecting air pressure and humidity sensor
2021-12-14 Fix typos, add power supply requirement to MCU selection section
2021-12-16 Add block schematic to introduction section, add ADC section and LoRa module selection section
2021-12-17 Add text section with power supplies
2021-12-18 Add stepdown schematic
2021-12-18 Add linear voltage regulator section
2021-12-18 Add more text to schematics section, add full block schematics
2021-12-18 Add PCB making section
2022-01-18 Add prototype of veml7700 library
2022-01-20 Working light sensor library
2022-01-25 First prototype of BMP lib
2022-01-26 Working pms sensor
2022-01-30 Read calibration data from BMP388, make some adjustment to I2C driver, use thread in main program
2022-01-30 Repair pressure measurement
2022-01-31 Working relative pressure calculation with compensation
2022-02-08 Working dust, temp, humidity, light, pressure
2022-02-09 First prototype of SPI library
2022-02-11 Add more print info from PMS sensor, fix typo in mcp sensor
    [main.cpp]
2022-02-15 Moved HW v0.1 project files
    [interface.sch, iotAirMonitoring.kicad_pcb, iotAirMonitoring.sch, powerManagement.sch]
2022-02-15 Move latex .gitignore, which was causing problems in folder name with dot
    [interface.sch, iotAirMonitoring.kicad_pcb, iotAirMonitoring.sch, powerManagement.sch]
2022-02-15 Start work at batteryCharger
    [batteryCharger.kicad_pcb, batteryCharger.kicad_sch]
2022-02-17 Routing charger
    [batteryCharger.kicad_pcb]
2022-02-17 Finish routing chargerBoard
    [batteryCharger.kicad_pcb]
2022-02-20 Add packages, start making v1.0
    [interface.kicad_sch, interface.sch, mainBoard.kicad_sch, mainBoard.sch, powerManagement.kicad_sch, powerManagement.sch]
2022-02-21 Create sensor footprints and symbols
2022-02-27 Start routing PCB
    [interface.kicad_sch, mainBoard.kicad_pcb, mainBoard.kicad_sch, powerManagement.kicad_sch]
2022-03-01 More component placement in mainboard
    [mainBoard.kicad_pcb]
2022-03-02 Maybe final component placement
    [interface.kicad_sch, mainBoard.kicad_pcb, mainBoard.kicad_sch, powerManagement.kicad_sch]
2022-03-02 Start routing mainBoard
    [mainBoard.kicad_pcb, mainBoard.kicad_sch]
2022-03-03 More routing at mainBoard
    [mainBoard.kicad_pcb]
2022-03-03 Maybe finished first component placement and routing mainBoard
    [mainBoard.kicad_pcb]
2022-03-04 Tweak silkscreen at mainBoard, add MPPT option to batteryCharger
    [batteryCharger.kicad_pcb, batteryCharger.kicad_sch, mainBoard.kicad_pcb]
2022-03-04 Finished v1.0, mainBoard, batteryCharger
    [batteryCharger.kicad_pcb]
2022-04-04 Improved deep sleep current consumption
2022-04-13 Reworked checking completed tasks, cleanup code
    [AirMonitoring_pinout.hpp, AirMonitoring_power.cpp, AirMonitoring_power.hpp, AirMonitoring_utils.cpp, AirMonitoring_utils.hpp, main.cpp, main.hpp]
2022-04-16 Add battery voltage measurement
2022-04-18 Fix SHT40 read issue
    [main.cpp]
2022-04-22 Fix issue with connecting to TTN after deepsleep, improve battery voltage reading and power off device when low voltage
    [AirMonitoring_utils.cpp, main.cpp]
2022-04-30 Work at selecting carbon dioxide sensor
2022-05-09 Created HW mainBoard v1.1, fix mirrored footprint, RFM95W to SMD fotprint, silkscreen and add sensor board with light sensors
    [interface.kicad_sch, interface.sch, light_sensors.kicad_sch, main.kicad_pcb, mainBoard.kicad_pcb, mainBoard.kicad_sch, mainBoard.sch, powerManagement.kicad_sch]
2022-05-10 Add power section to text
2022-05-16 Fixed powering device off when low voltage
    [AirMonitoring_power.cpp, main.cpp]
2022-05-17 Added step-up section and schematics, switched to bachelor instead of semestral work, fix some mistakes
2022-05-18 Replaced final block schematic
2022-05-18 Add text to final conencting of device
2022-05-19 Add battery charger section
2022-05-19 Finish batteryCharger text section, add schematics into it
2022-05-21 Add PCB making up section
2022-05-22 Add PCB renders from KiCad
2022-05-22 Add flowchart, more software text
2022-05-22 Add device configuring for TTN
2022-05-23 Beautify schematics in KiCad
    [interface.kicad_sch, light_sensors.kicad_sch, mainBoard.kicad_sch, powerManagement.kicad_sch]
2022-05-23 Inlcude schematics in text
    [batteryCharger.kicad_sch]
2022-05-25 Add case section, add data flow diagram
2022-05-26 Add final PCB photos
2022-05-26 Mirror 1.8V LDO in schematic, replaced in text
    [interface.kicad_sch]
2022-05-26 Add BOM for PCBs, renew included schematic of mainBoard, start work at toc of attachments, add 3D models
    [case_bot.SLDPRT, case_top.SLDPRT]
2022-05-26 fw: Fix I2C communication for mainBoard v1.1 -> delay at boot for coltage stabilisation at sensors
    [main.cpp]
2022-05-27 fw: add missing WIF_CHECKER to run task with MQTT
    [main.cpp]
2022-05-27 Add info about used library in fw, add toc of electronical attachment
2022-05-29 Add final pjhoto of device
